jriesen/TennisButler/cv/calibration/calibration-images/IMG_3978.jpeg

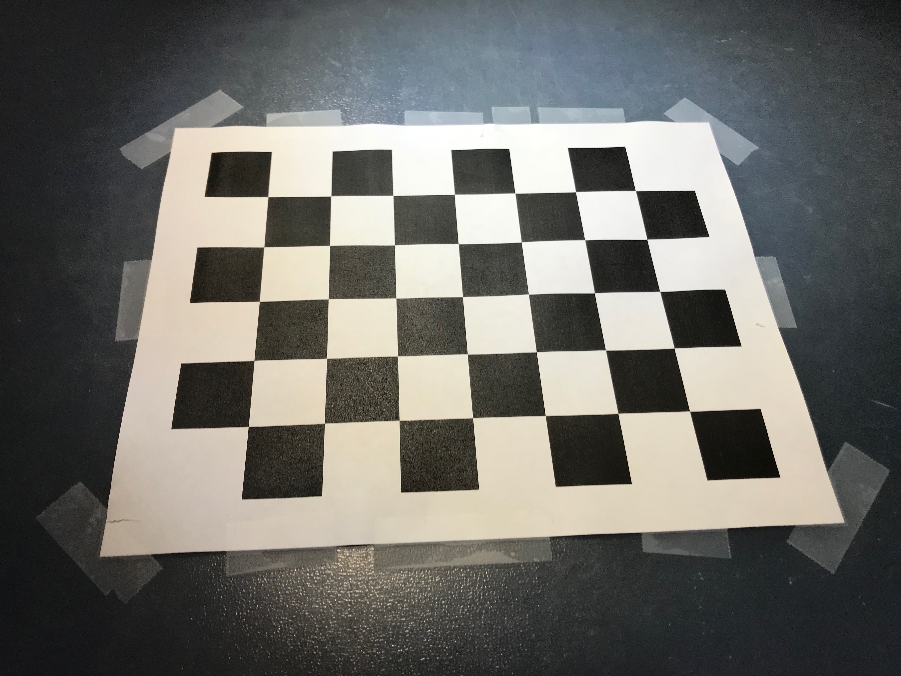
cv/calibration/calibration-images/IMG_3978.jpeg
