jriesen/TennisButler/cv/calibration/calibration-images/IMG_3970.jpeg

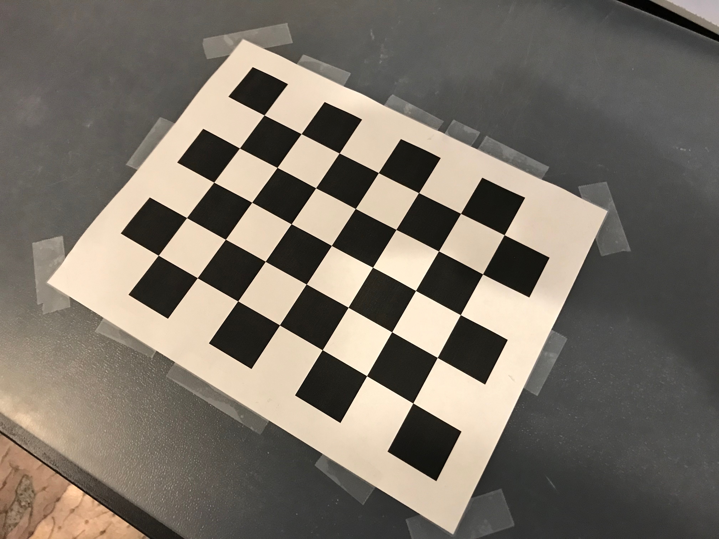
cv/calibration/calibration-images/IMG_3970.jpeg
