jriesen/TennisButler/README.md

# Tennis Butler
All assets for the Tennis Butler autonomous ball collector (senior design project)
