jriesen/TennisButler/cv/court_transform/images/IMG_3774.jpeg

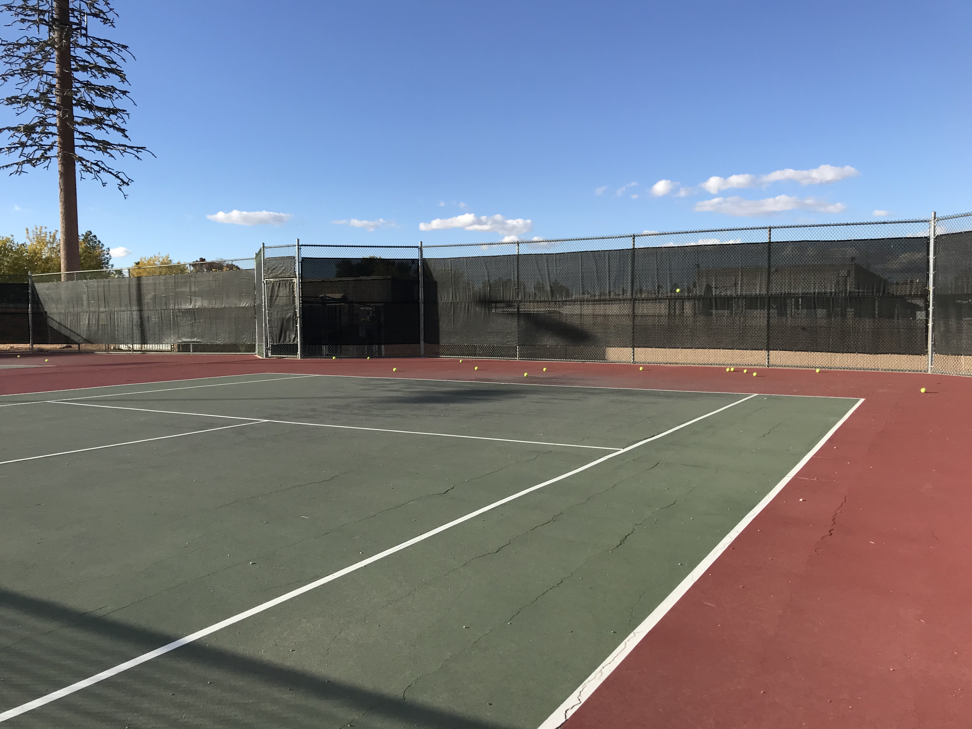
cv/court_transform/images/IMG_3774.jpeg
