jriesen/TennisButler/cv/court_transform/images/IMG_3787.jpeg

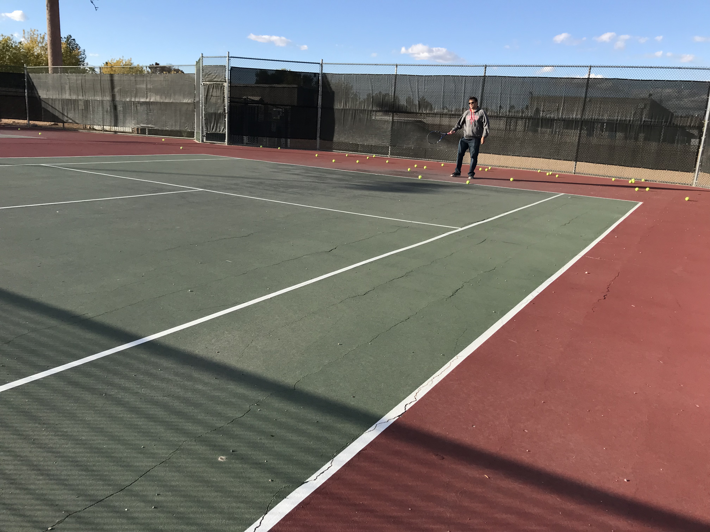
cv/court_transform/images/IMG_3787.jpeg
