jriesen/TennisButler/cv/court_transform/images/IMG_3933.jpeg

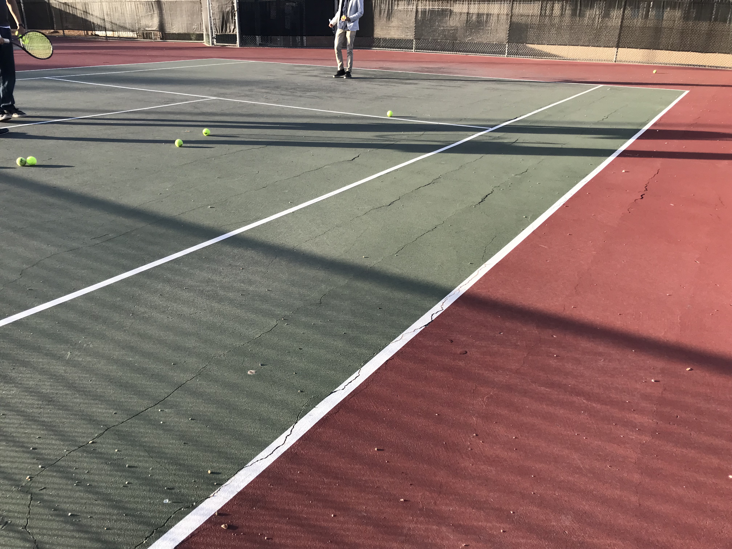
cv/court_transform/images/IMG_3933.jpeg
