jriesen/TennisButler/cv/court_transform/images/IMG_3947.jpeg

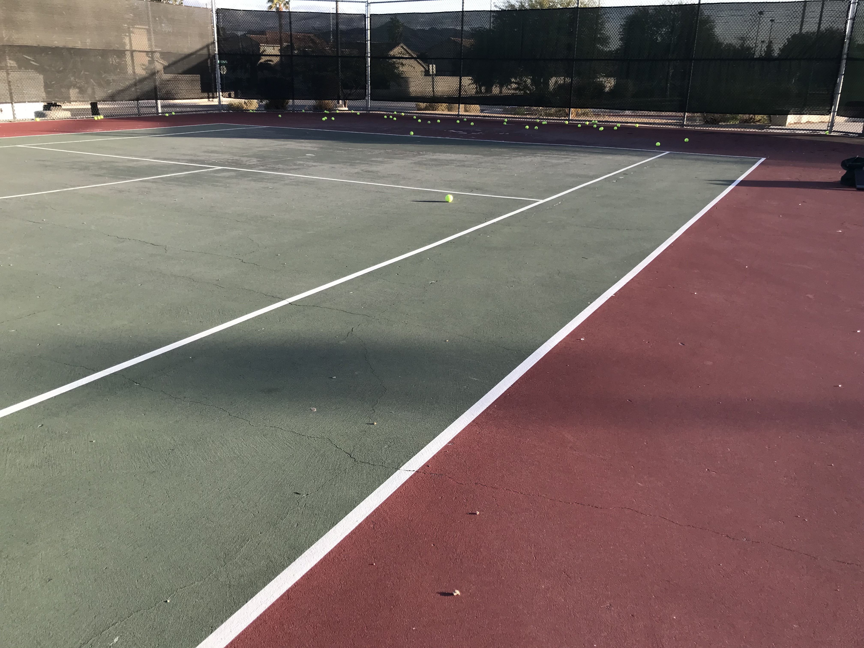
cv/court_transform/images/IMG_3947.jpeg
