jriesen/TennisButler/original-cv/court.jpg

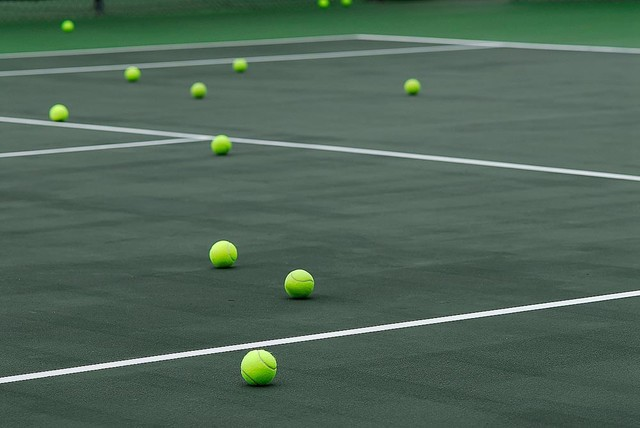
original-cv/court.jpg
