jriesen/TennisButler/cv/calibration/calibration-images/IMG_3965.jpeg

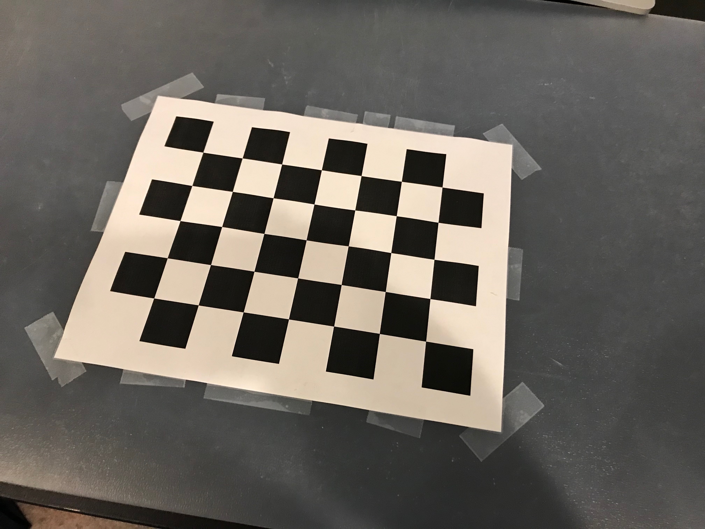
cv/calibration/calibration-images/IMG_3965.jpeg
