jriesen/TennisButler/cv/calibration/calibration-images/IMG_3966.jpeg

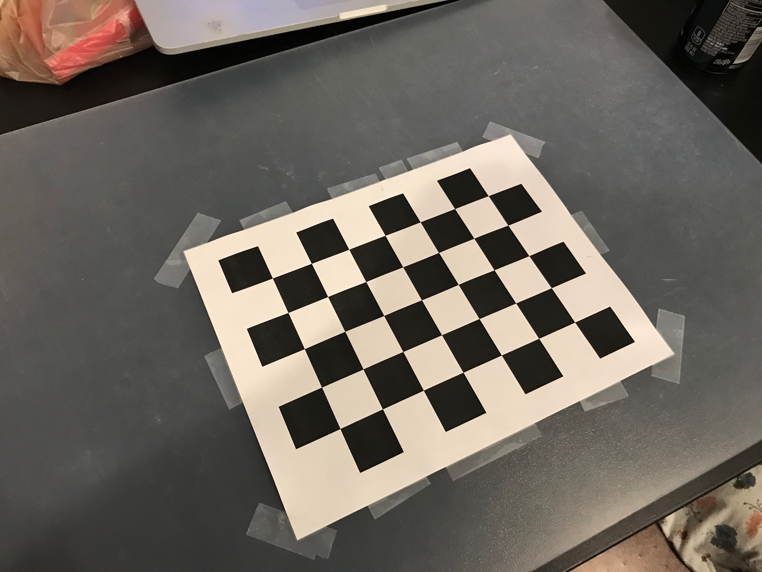
cv/calibration/calibration-images/IMG_3966.jpeg
