jriesen/TennisButler/cv/calibration/calibration-images/IMG_3967.jpeg

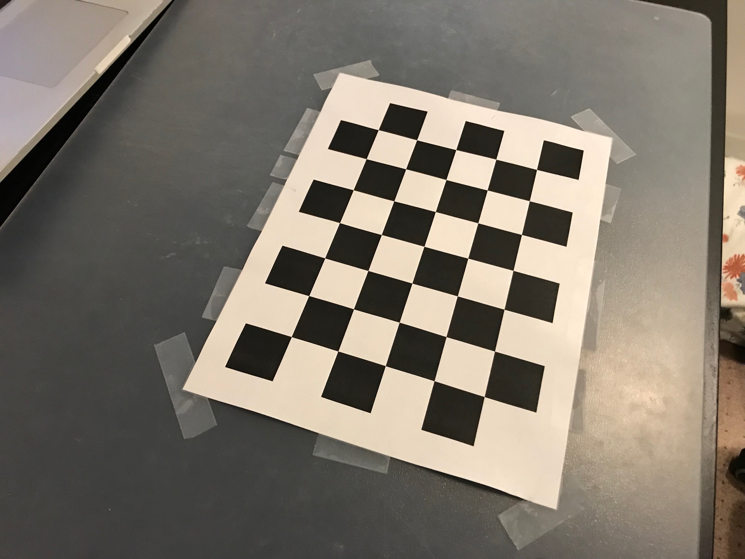
cv/calibration/calibration-images/IMG_3967.jpeg
