jriesen/TennisButler/cv/calibration/calibration-images/IMG_3968.jpeg

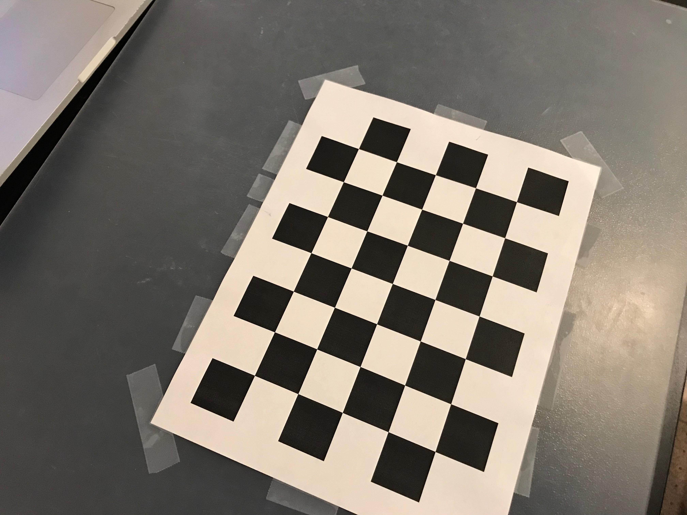
cv/calibration/calibration-images/IMG_3968.jpeg
