jriesen/TennisButler/cv/calibration/calibration-images/IMG_3969.jpeg

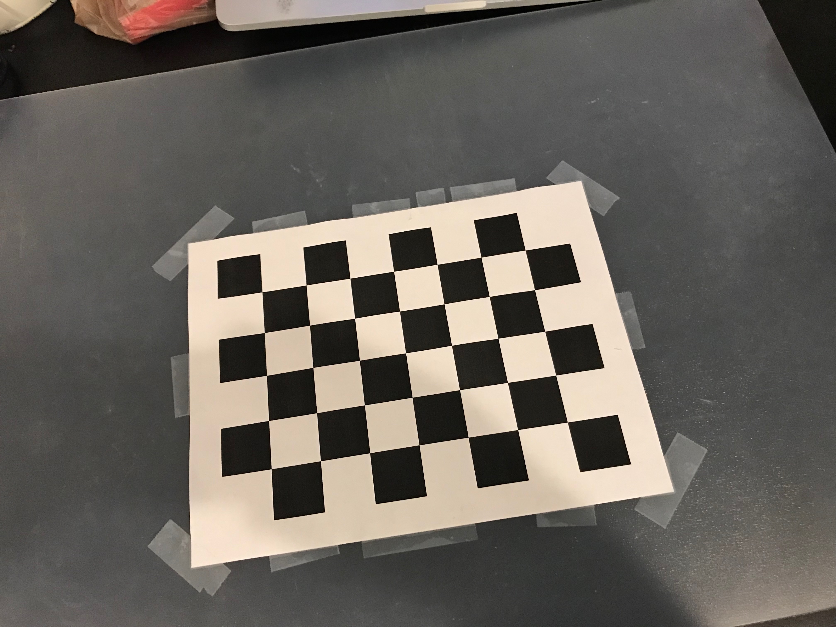
cv/calibration/calibration-images/IMG_3969.jpeg
