jriesen/TennisButler/cv/calibration/calibration-images/IMG_3971.jpeg

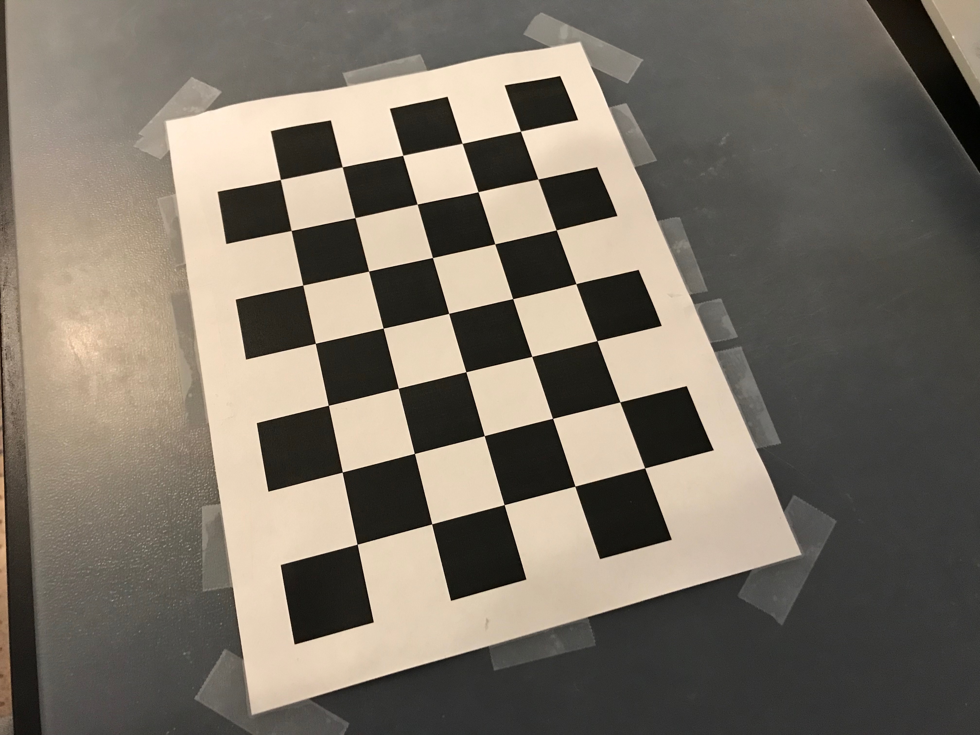
cv/calibration/calibration-images/IMG_3971.jpeg
