jriesen/TennisButler/cv/calibration/calibration-images/IMG_3972.jpeg

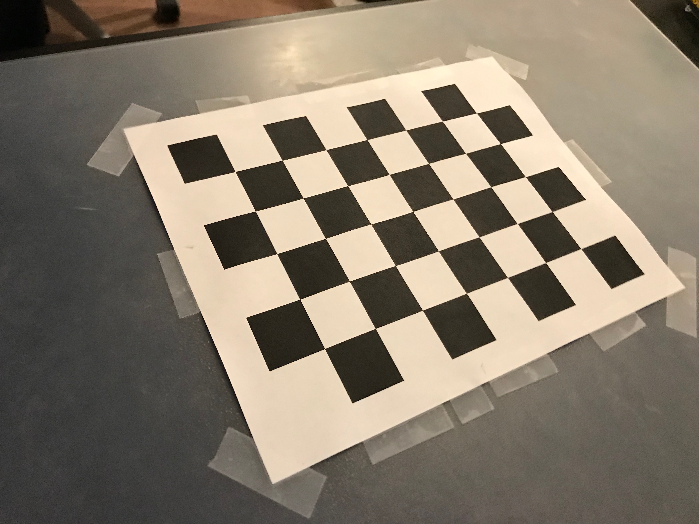
cv/calibration/calibration-images/IMG_3972.jpeg
