jriesen/TennisButler/cv/calibration/calibration-images/IMG_3973.jpeg

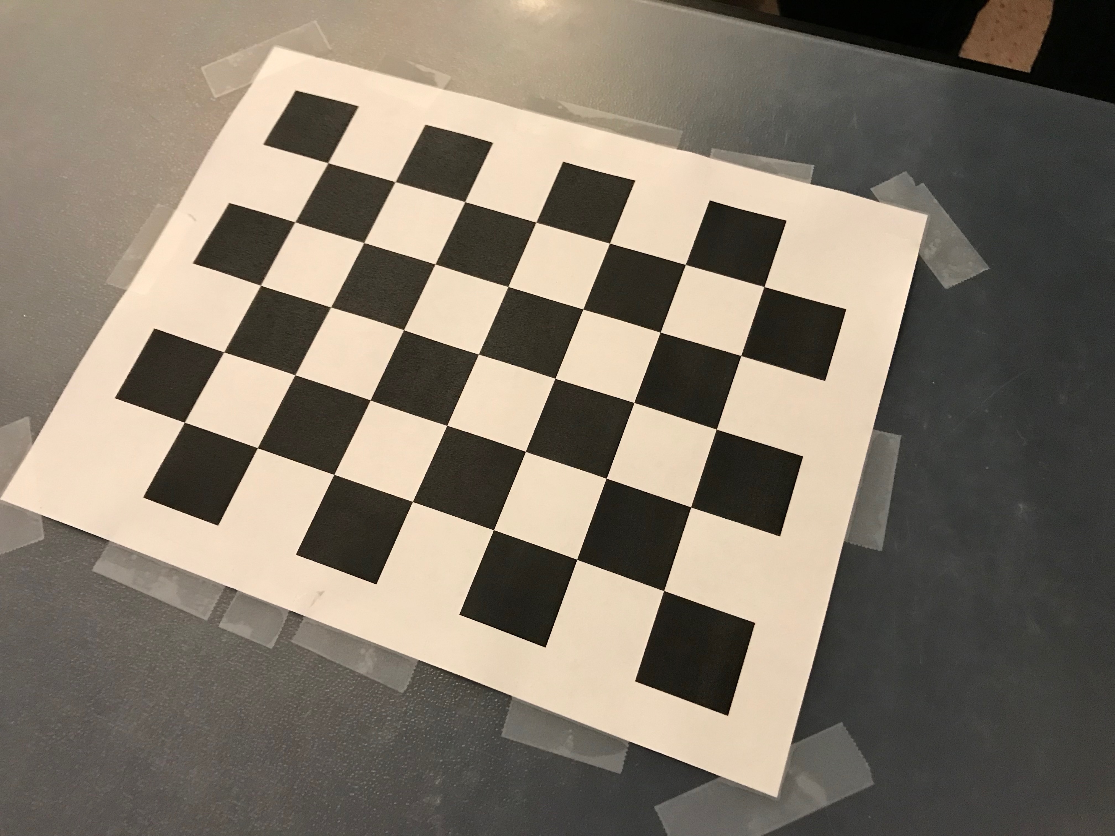
cv/calibration/calibration-images/IMG_3973.jpeg
