jriesen/TennisButler/cv/calibration/calibration-images/IMG_3974.jpeg

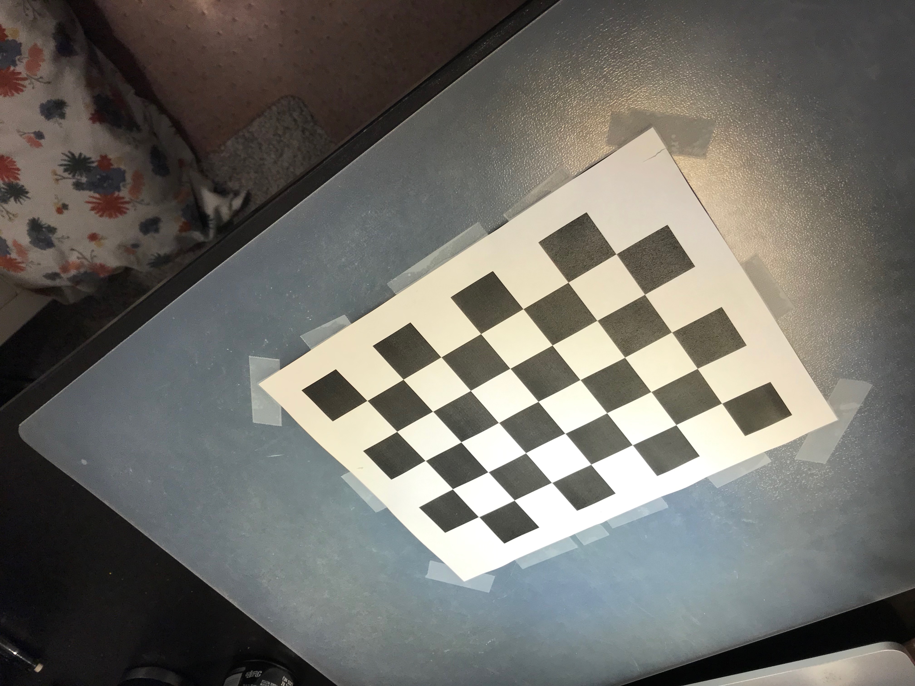
cv/calibration/calibration-images/IMG_3974.jpeg
