jriesen/TennisButler/cv/calibration/calibration-images/IMG_3975.jpeg

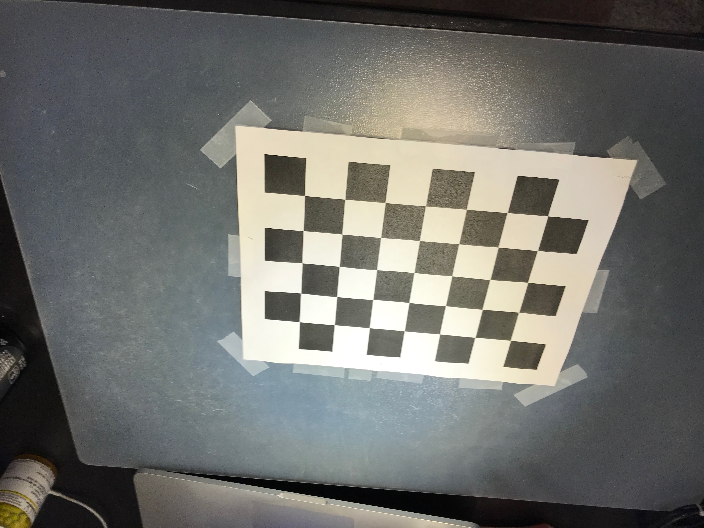
cv/calibration/calibration-images/IMG_3975.jpeg
