jriesen/TennisButler/cv/calibration/calibration-images/IMG_3977.jpeg

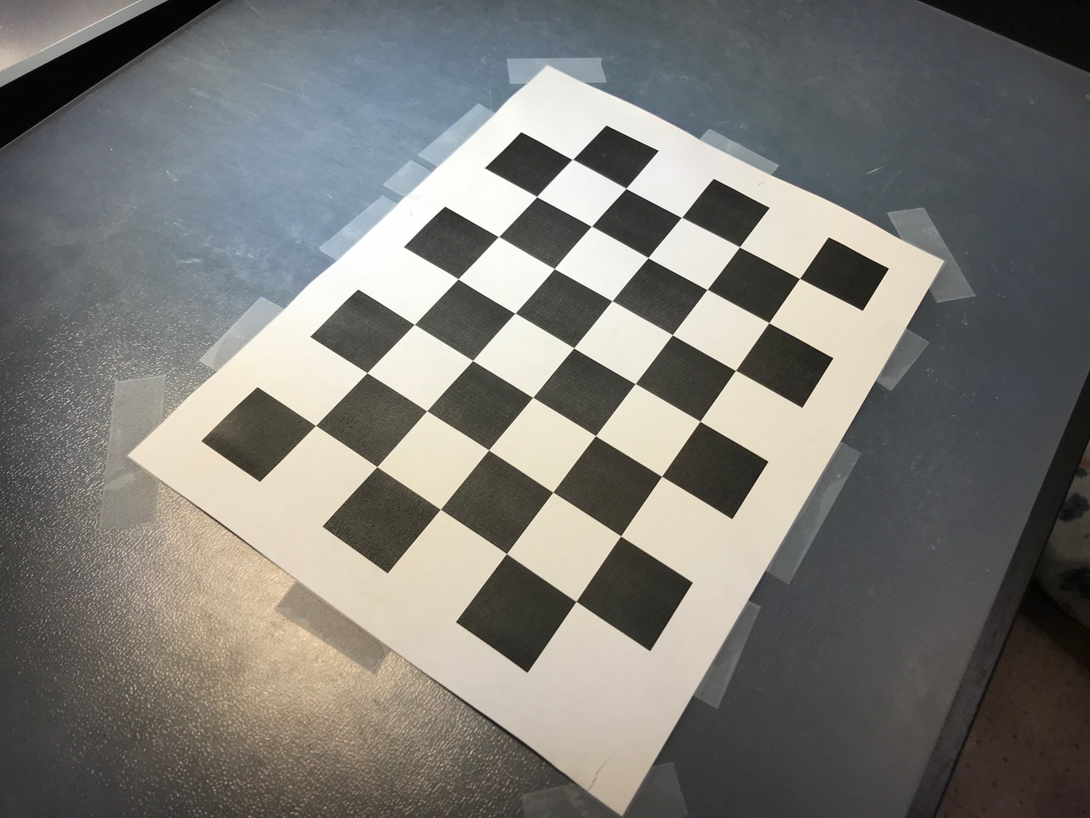
cv/calibration/calibration-images/IMG_3977.jpeg
