jriesen/TennisButler/cv/calibration/calibration-images/IMG_3983.jpeg

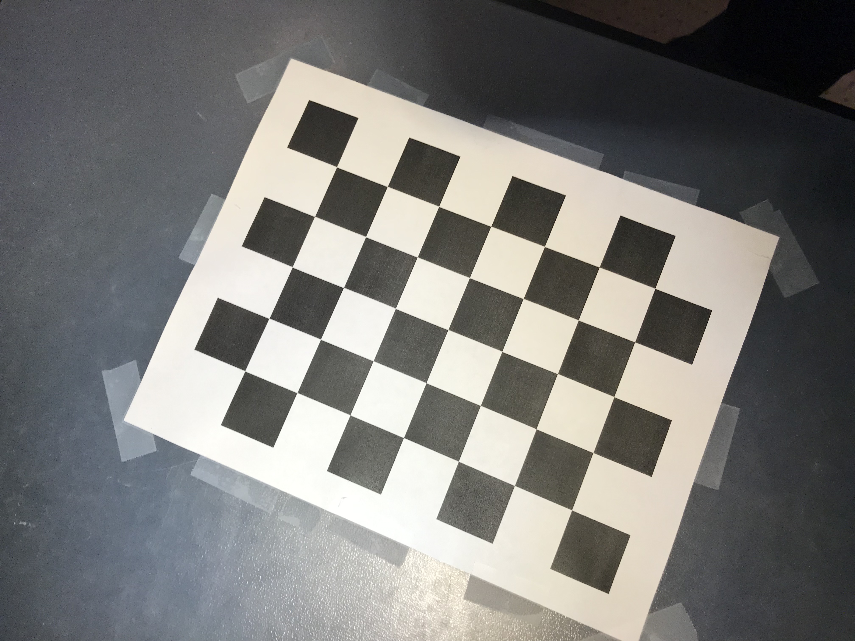
cv/calibration/calibration-images/IMG_3983.jpeg
