jriesen/TennisButler/cv/calibration/calibration-images/IMG_3984.jpeg

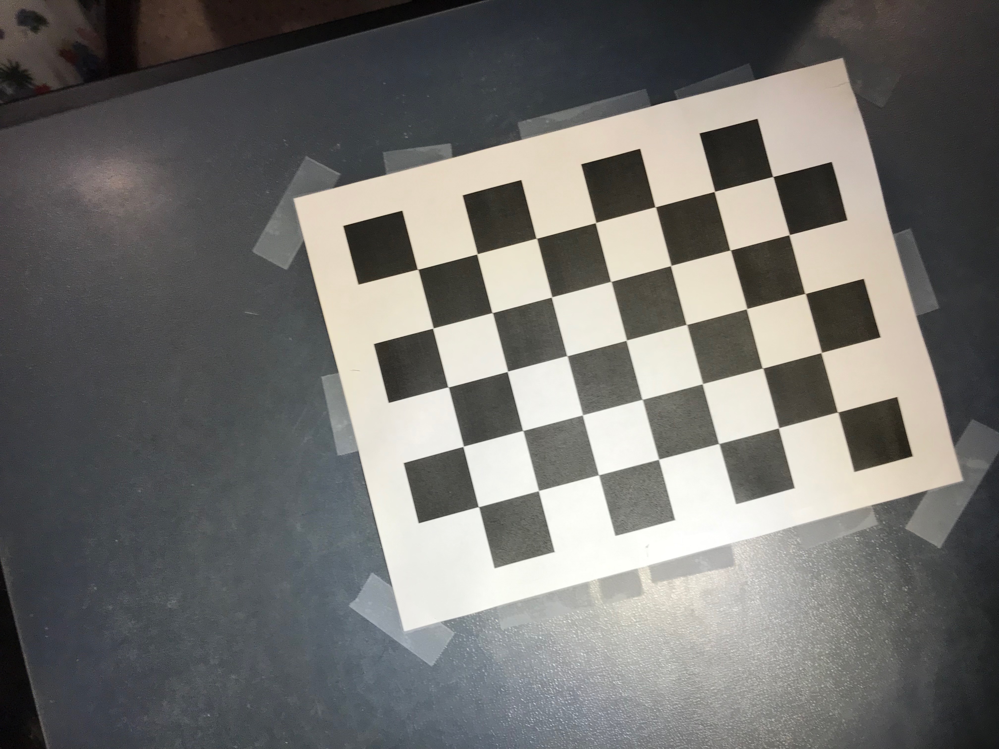
cv/calibration/calibration-images/IMG_3984.jpeg
