jriesen/TennisButler/cv/calibration/calibration-images/IMG_3992.jpeg

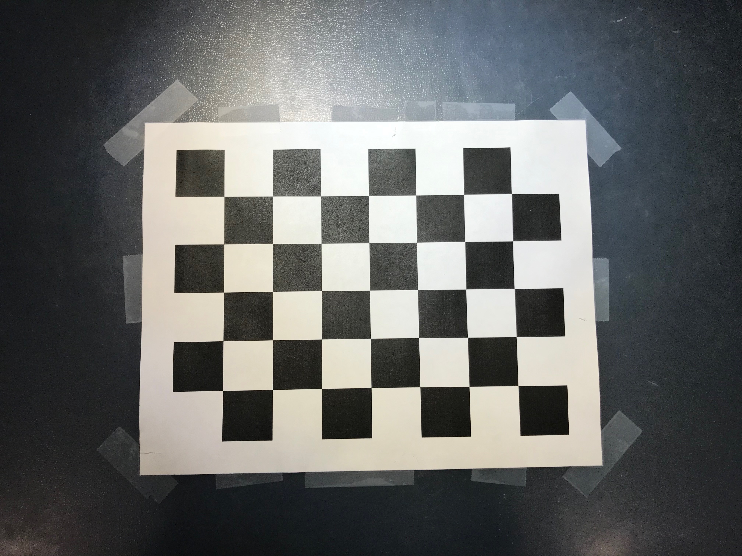
cv/calibration/calibration-images/IMG_3992.jpeg
