jriesen/TennisButler/cv/calibration/calibration-images/IMG_3993.jpeg

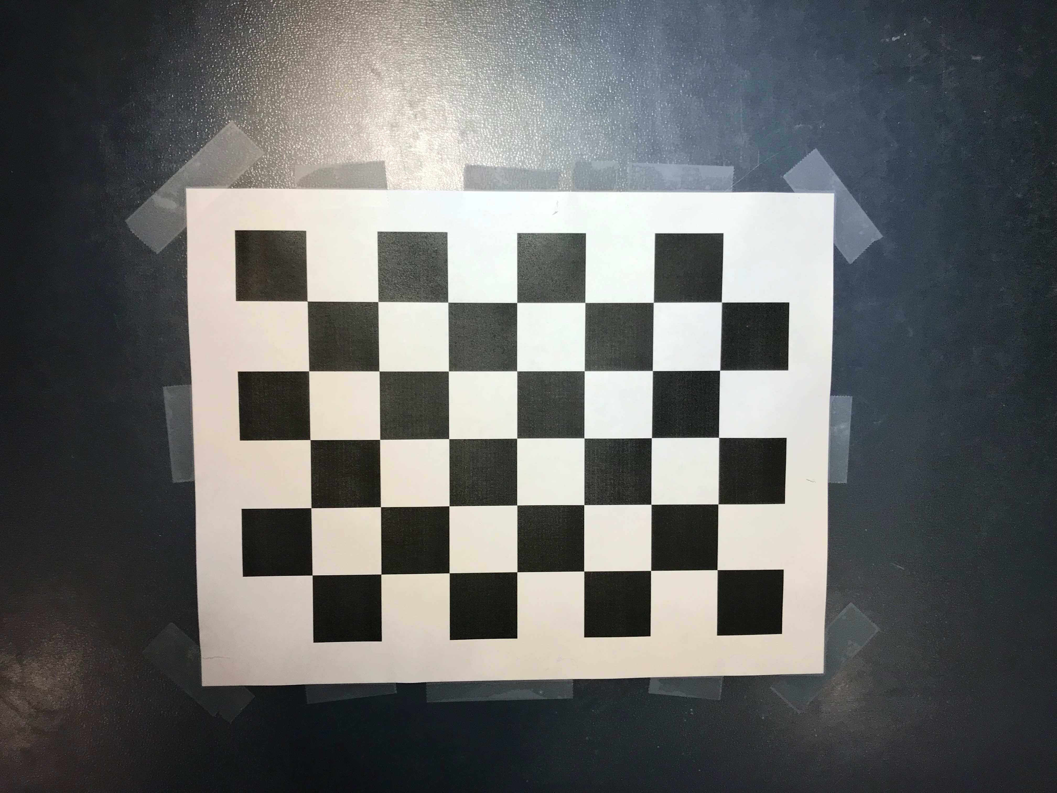
cv/calibration/calibration-images/IMG_3993.jpeg
