jriesen/TennisButler/cv/calibration/calibration-images/IMG_3994.jpeg

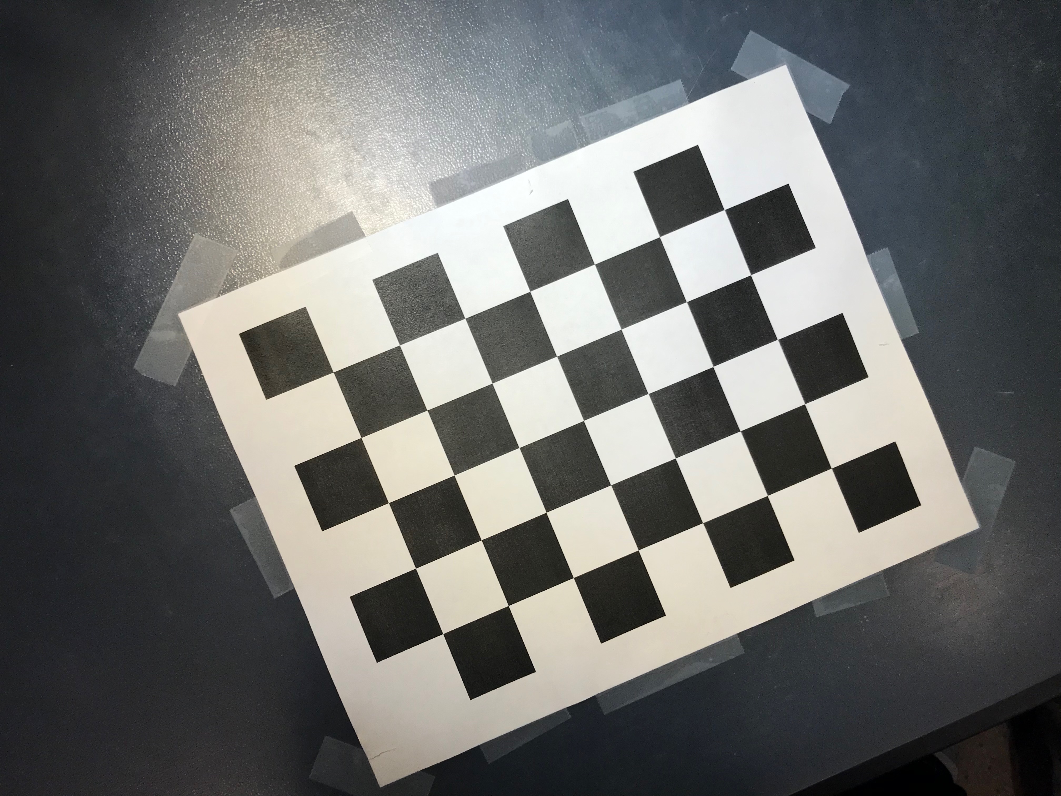
cv/calibration/calibration-images/IMG_3994.jpeg
