jriesen/TennisButler/hardware/Documentation/Schematics.PDF

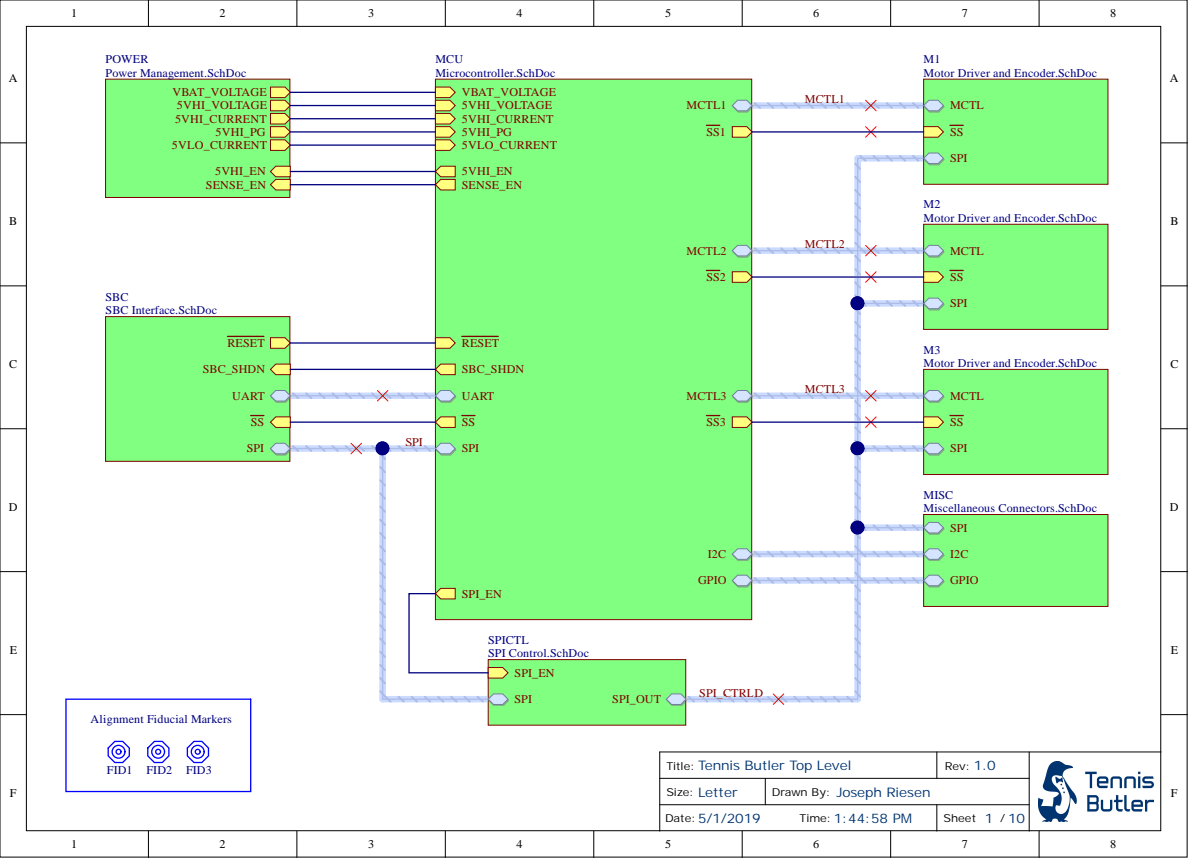
[picture p24: page 1]

Motor Driver and Encoder.SchDoc

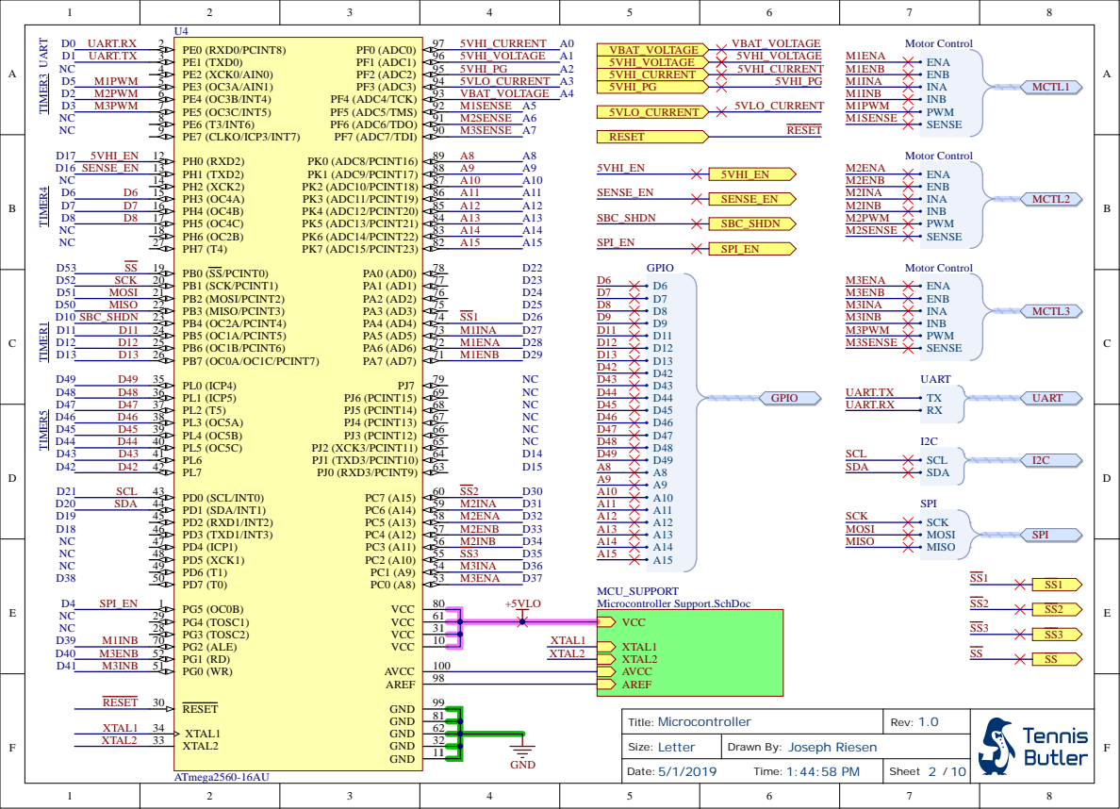
[picture p25: page 2]

8 1
6 2

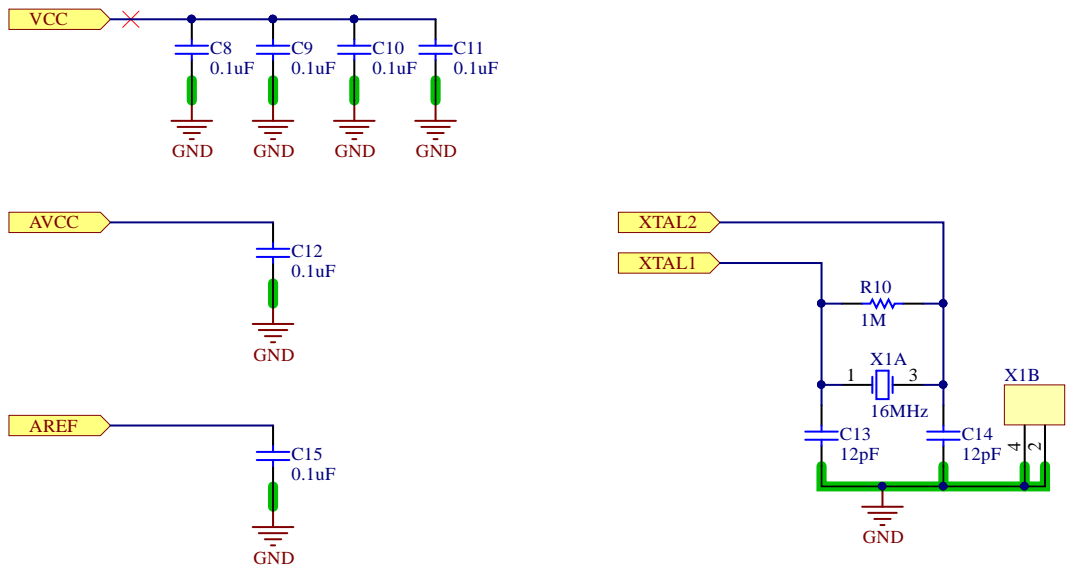
[picture p26: page 3]

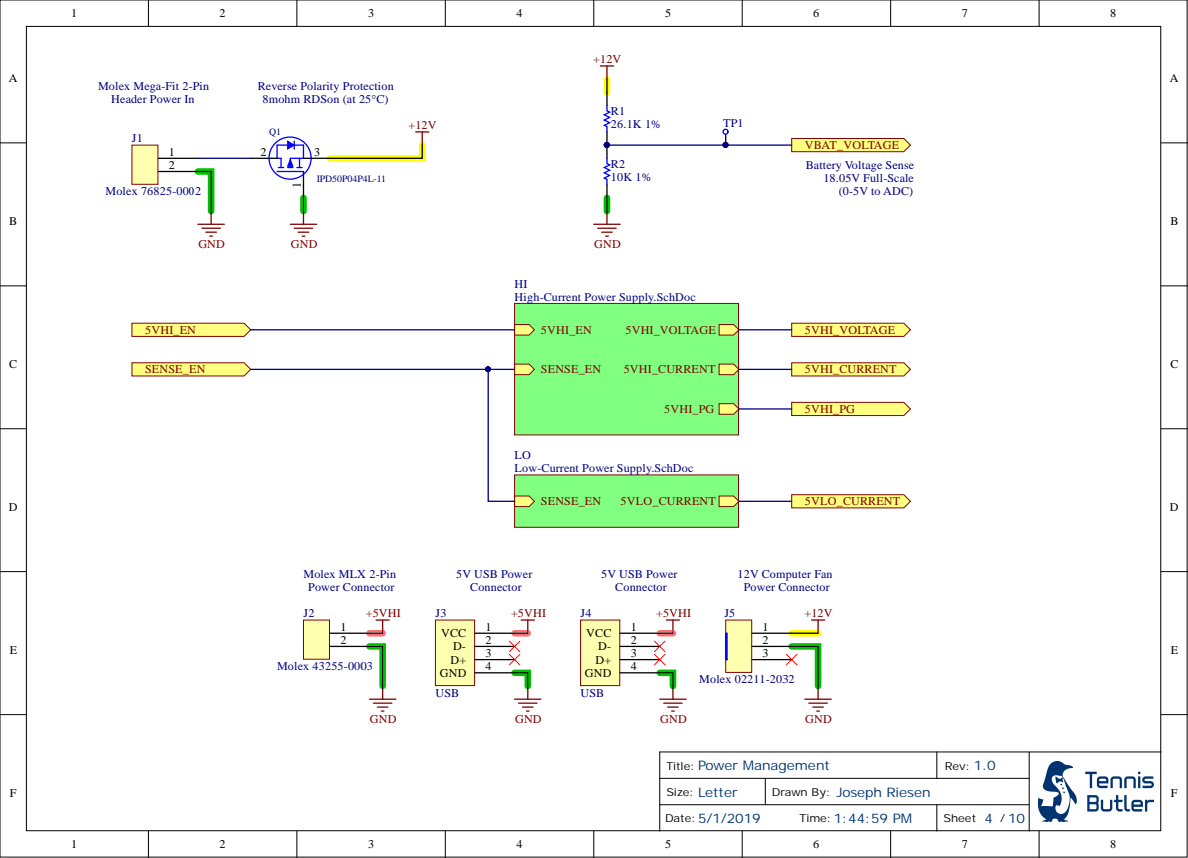
[picture p27: page 4]

Molex Mega-Fit 2-Pin
Header Power In

High-Current Power Supply.SchDoc

Low-Current Power Supply.SchDoc

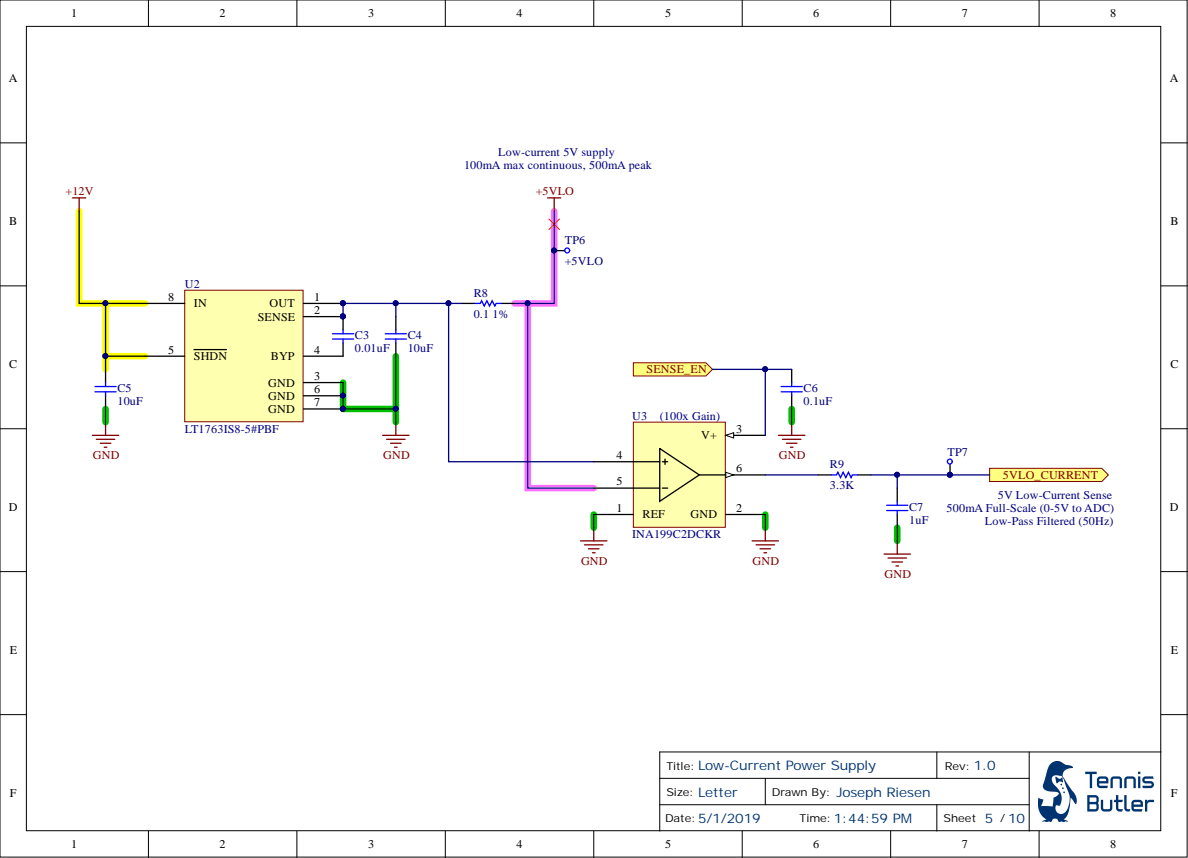
[picture p28: page 5]

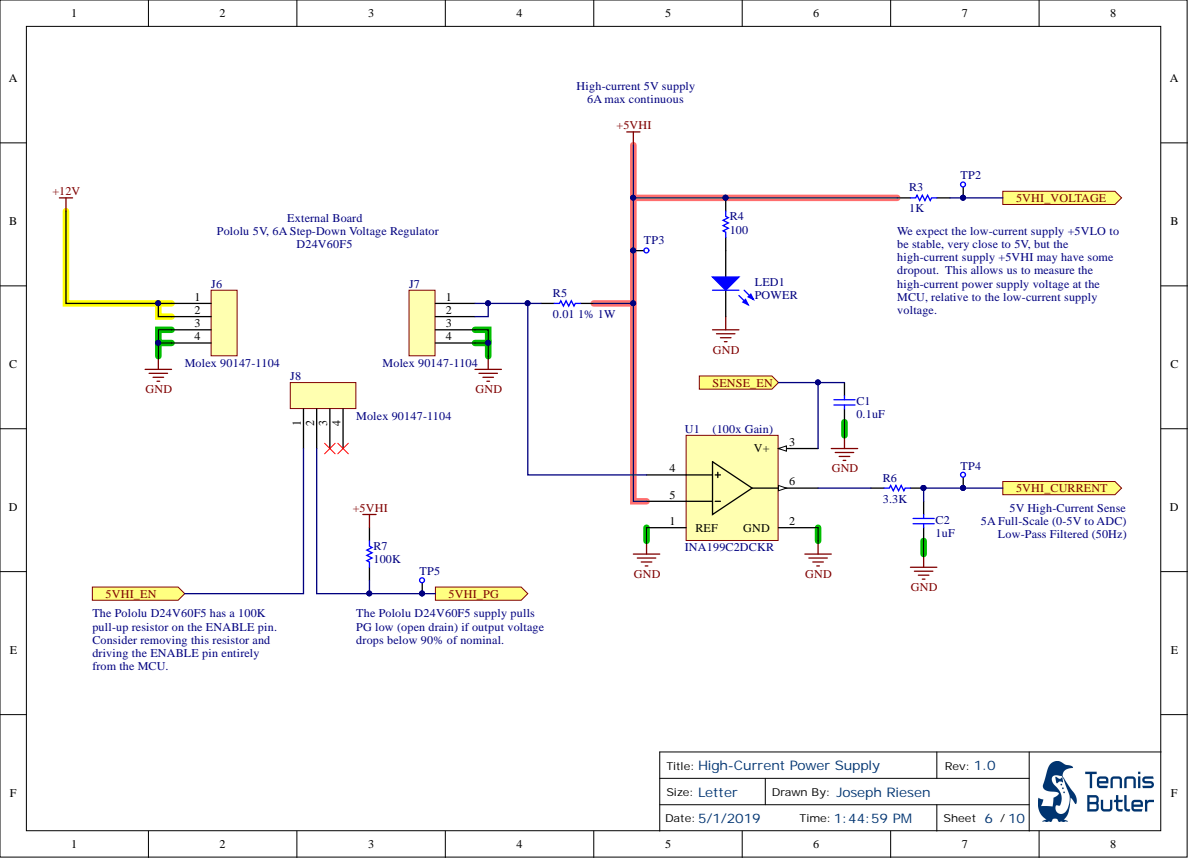
[picture p29: page 6]

Pololu 5V, 6A Step-Down Voltage Regulator

We expect the low-current supply +5VLO to
be stable, very close to 5V, but the
high-current supply +5VHI may have some
dropout. This allows us to measure the
high-current power supply voltage at the
MCU, relative to the low-current supply
voltage.

5VHI_CURRENT
5V High-Current Sense
5A Full-Scale (0-5V to ADC)
Low-Pass Filtered (50Hz)

The Pololu D24V60F5 has a 100K
pull-up resistor on the ENABLE pin.
Consider removing this resistor and
driving the ENABLE pin entirely
from the MCU.

The Pololu D24V60F5 supply pulls
PG low (open drain) if output voltage
drops below 90% of nominal.

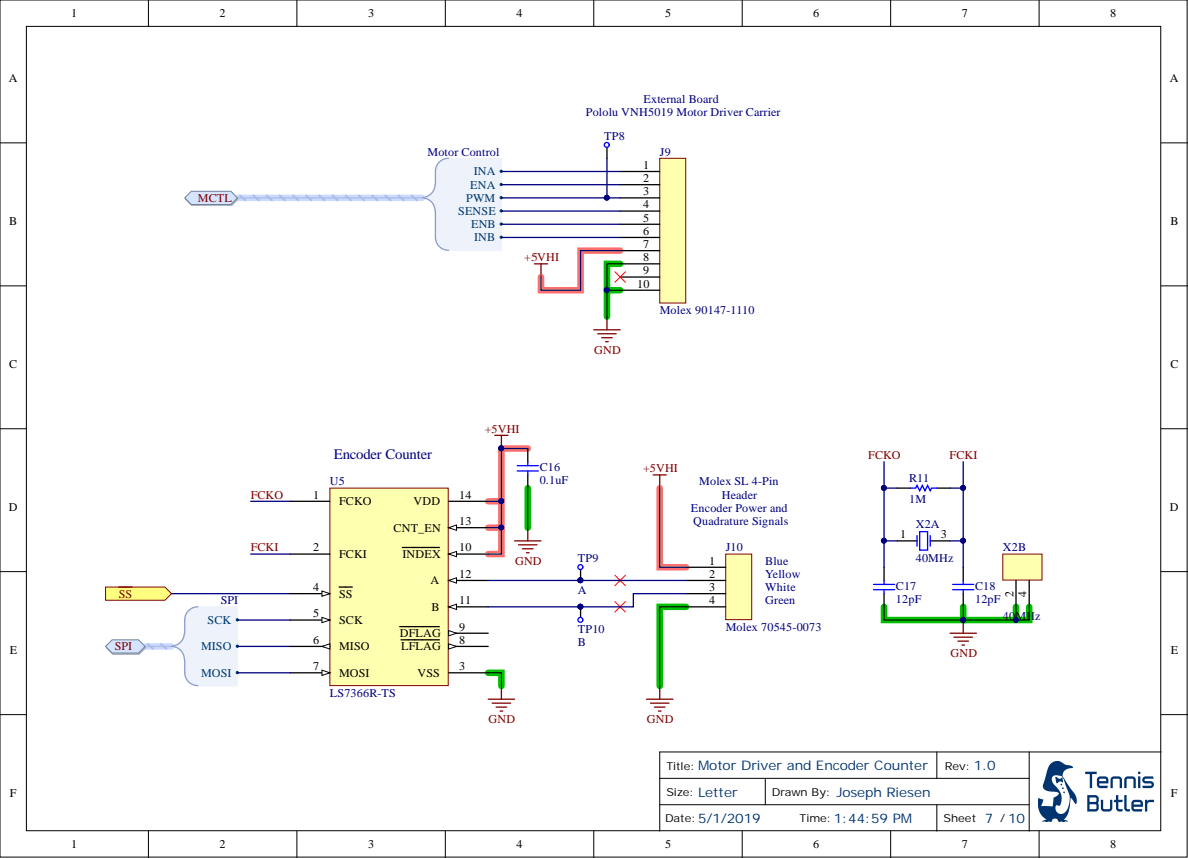
[picture p30: page 7]

Pololu VNH5019 Motor Driver Carrier

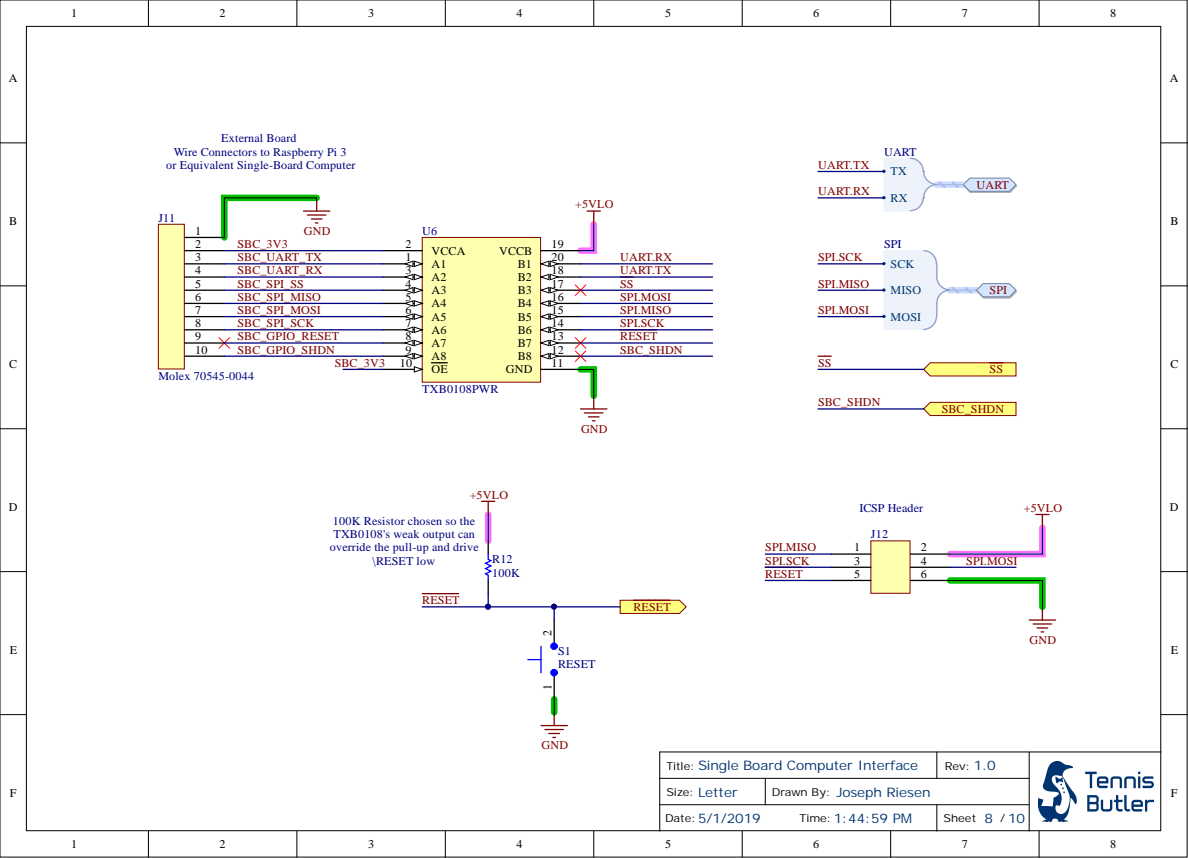
[picture p31: page 8]

Wire Connectors to Raspberry Pi 3
or Equivalent Single-Board Computer

100K Resistor chosen so the
TXB0108's weak output can
override the pull-up and drive

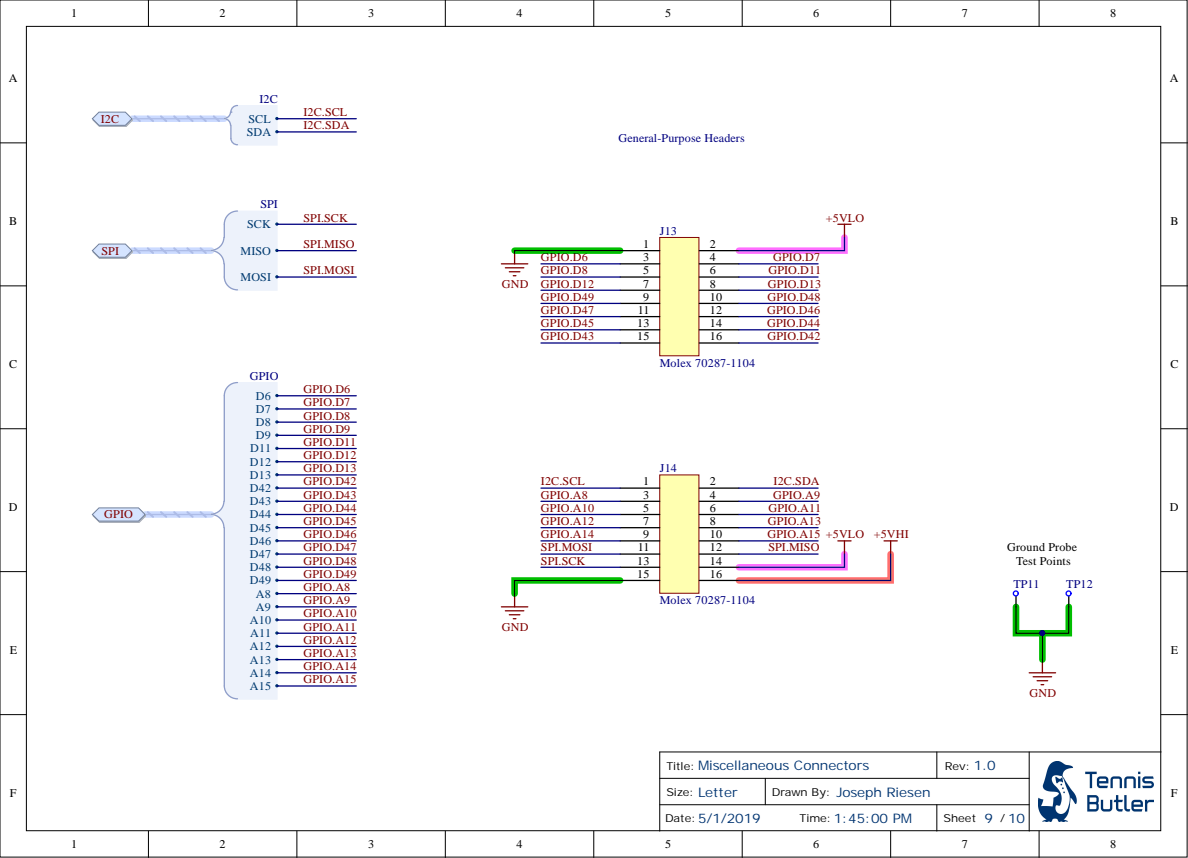
[picture p32: page 9]

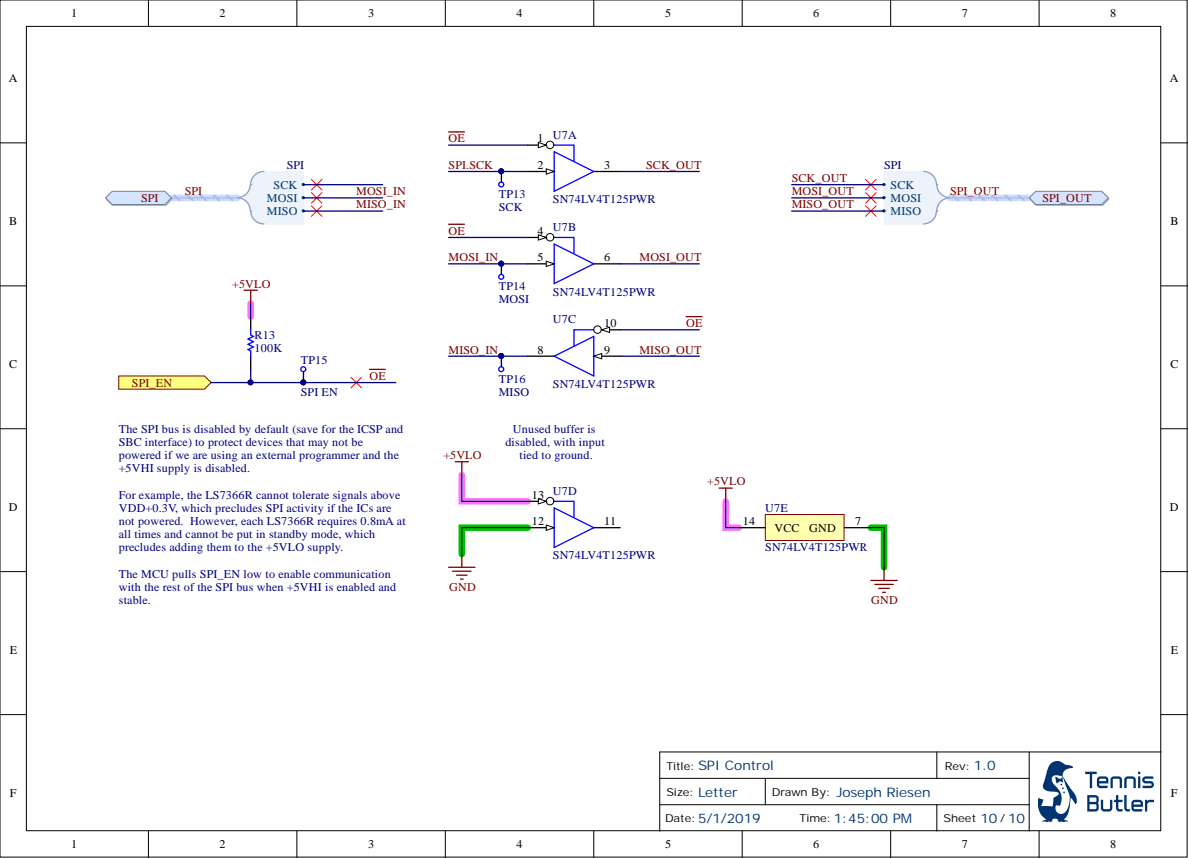
[picture p33: page 10]

The SPI bus is disabled by default (save for the ICSP and
SBC interface) to protect devices that may not be
powered if we are using an external programmer and the
+5VHI supply is disabled.

For example, the LS7366R cannot tolerate signals above
VDD+0.3V, which precludes SPI activity if the ICs are
not powered. However, each LS7366R requires 0.8mA at
all times and cannot be put in standby mode, which
precludes adding them to the +5VLO supply.

The MCU pulls SPI_EN low to enable communication
with the rest of the SPI bus when +5VHI is enabled and
stable.
