jriesen/TennisButler/hardware/Documentation/PCB.PDF

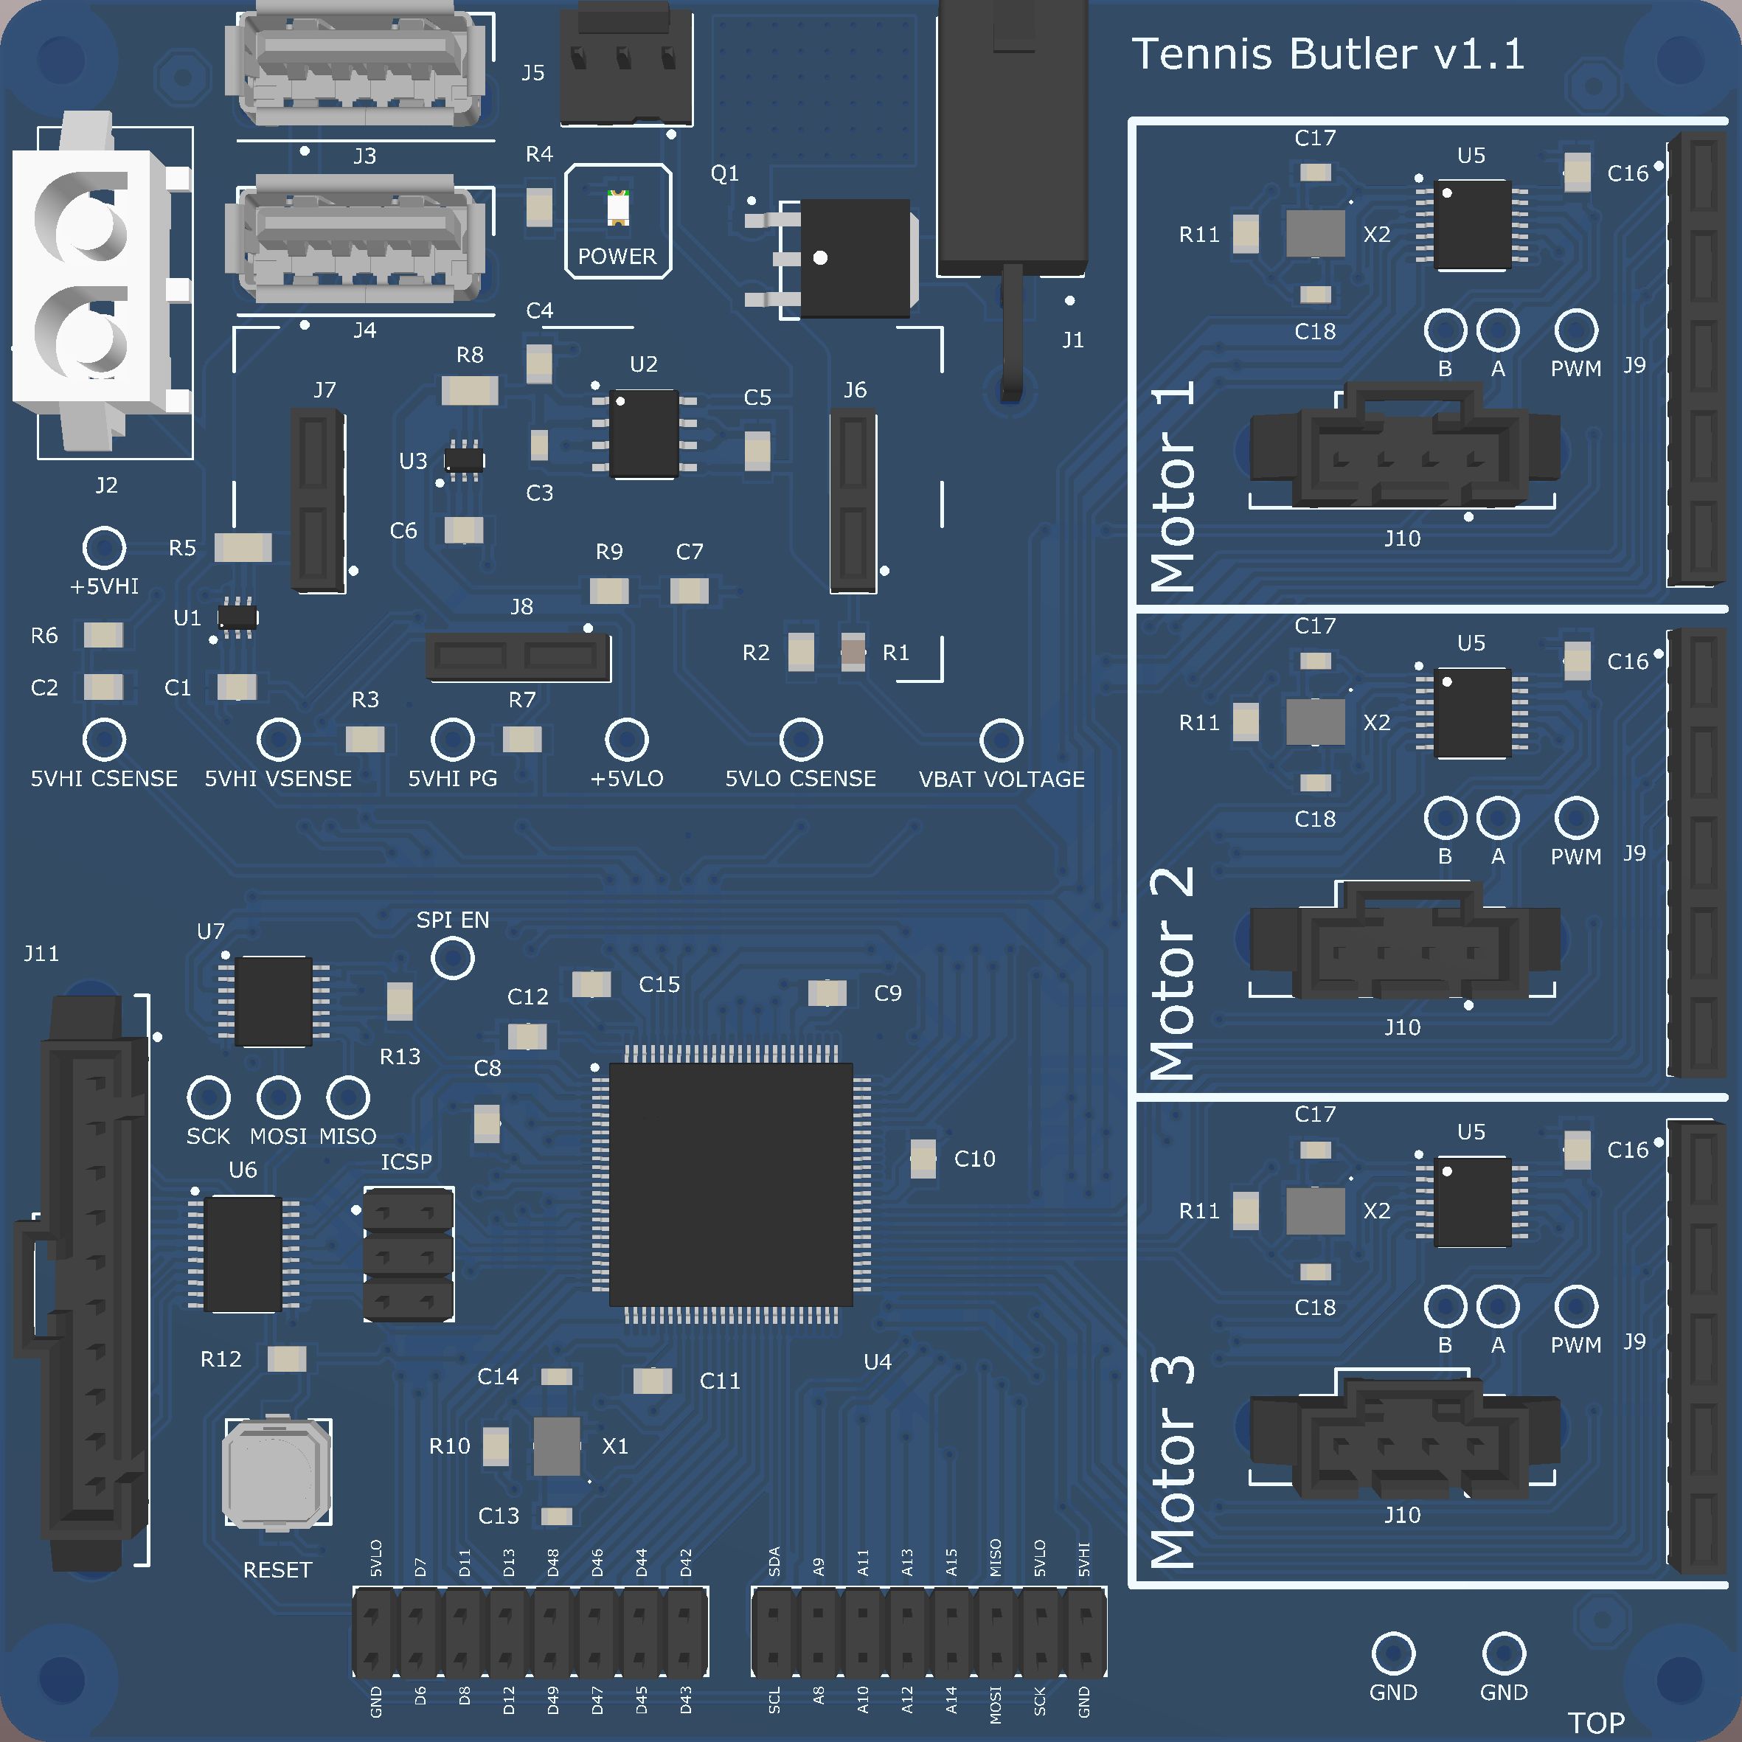
[picture p34: page 1]

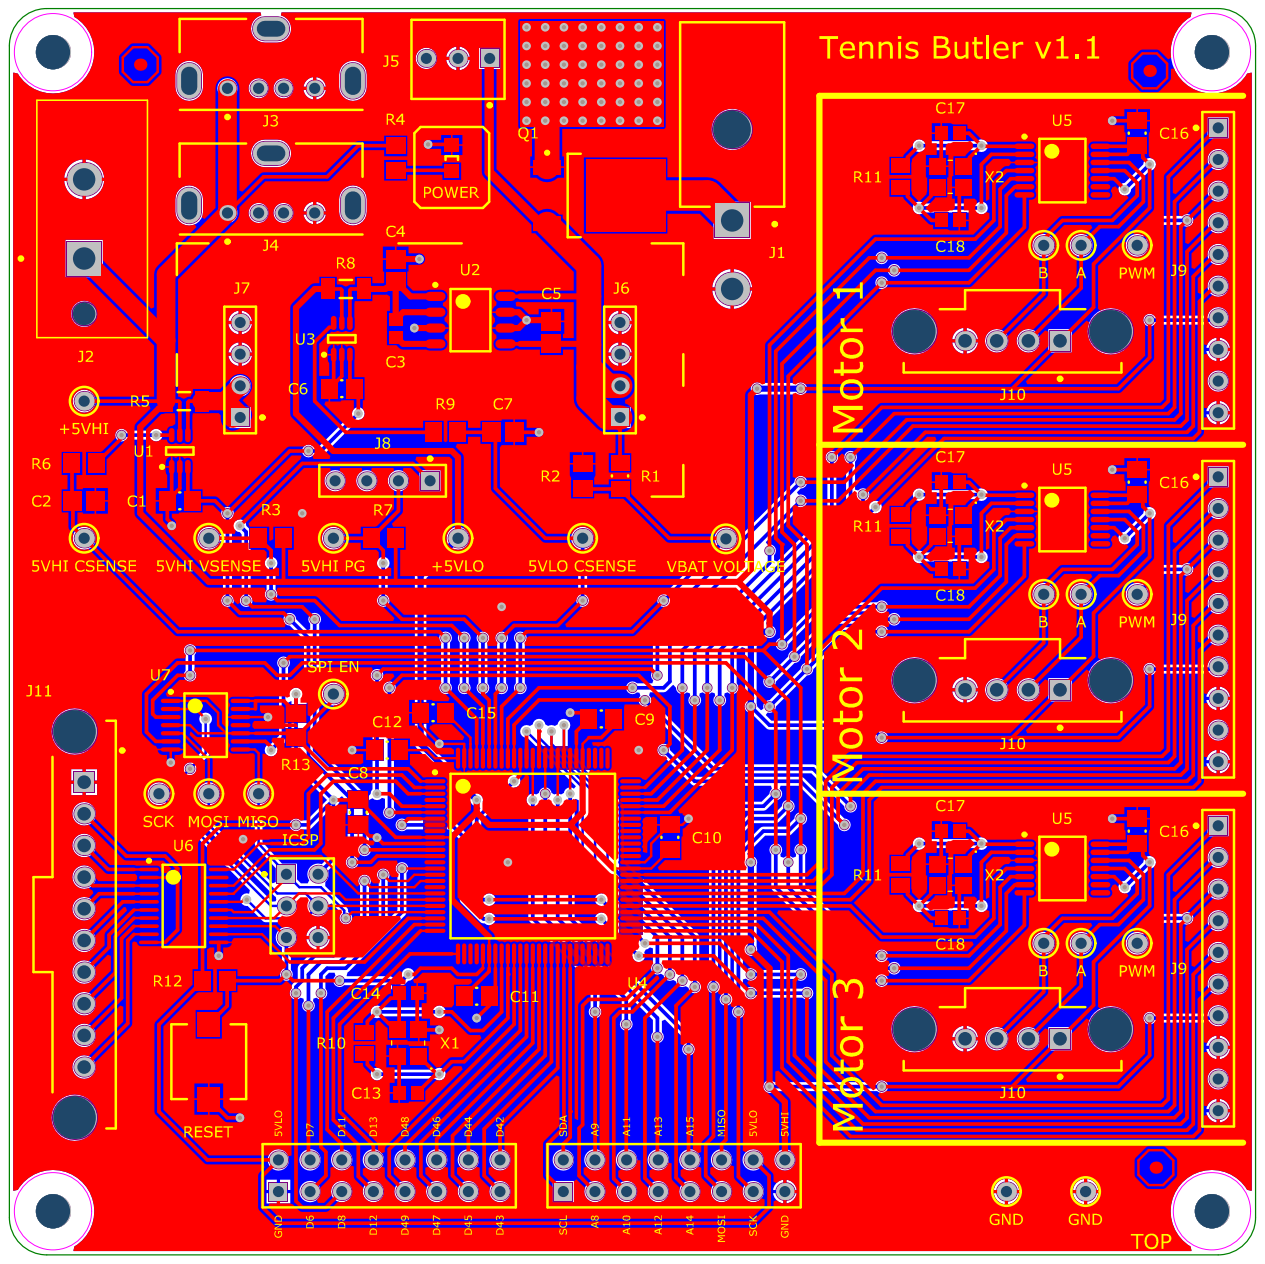
[picture p35: page 2]
