jriesen/TennisButler/(list of files, drawings)

Other design files:
hardware/PCB/TennisButler PCB.PcbDoc
hardware/Schematics/High-Current Power Supply.SchDoc
hardware/Schematics/LED Driver.SchDoc
hardware/Schematics/Low-Current Power Supply.SchDoc
hardware/Schematics/Microcontroller Support.SchDoc
hardware/Schematics/Microcontroller.SchDoc
hardware/Schematics/Miscellaneous Connectors.SchDoc
hardware/Schematics/Motor Driver and Encoder.SchDoc
hardware/Schematics/Power Management.SchDoc
hardware/Schematics/SBC Interface.SchDoc
hardware/Schematics/SPI Control.SchDoc
hardware/Schematics/Tennis Butler V1.0.SchDoc
hardware/TennisButler.PrjPcb
