jriesen/TennisButler/(commit log)

2018-12-06 Add new CV code: calibration, tennis court mapping
    The calibration photos probably aren't the best; I need to redo them
    with a rigid chessboard or the like. Then again, the iPhone photos
    are only for algorithm design and we'll be moving to a Pi camera V2
    very soon.
2019-03-06 Add initial Altium files to project
    This initial commit adds my current work on the Tennis Butler in
    Altium to the project. Mostly it's library footprint work and some
    initial work on a schematic template for the title block.
    [01 TOC.SchDoc, TennisButler PCB.PcbDoc, TennisButler.PrjPcb]
2019-03-09 Add a proper schematic template with logo
    [01 TOC.SchDoc]
2019-03-09 Update schematic template to 1-inch margins
    [01 TOC.SchDoc, TennisButler.PrjPcb]
2019-03-09 Alter TSOP-14 footprints to have rectangular pad 1
    The EEVBlog guy recommends using a rectangular pad for pin 1 as an extra
    identifier (in addition to the silkscreen) to ensure proper assembly.
2019-03-09 Remove IPC Medium and High Density footprints
    The low density footprint is recommended for "robust" solder joints and
    is recommended for military and medical applications. I don't need a
    very dense board, so I'm just removing these to reduce confusion and
    maintenance overhead. (After all, I still need to patch up the solder
    mask slivers on the pins.)
    See https://blogs.mentor.com/tom-hausherr/blog/2011/01/28/pcb-design-perfection-starts-in-the-cad-library-part-12/
    for more details.
2019-03-09 Add first-pass VNH5019 symbol and footprint
2019-03-09 Add Seeed DRC rule export
    This is my current best effort at interpreting the various Seeed Fusion
    PCB rules (especially for the cheap boards, i.e. 0.4mm solder mask dam)
    into Altium.
2019-03-09 Add "Motor Drivers" schematic sheet
    Not that there's anything in it yet, of course, but at least the title
    block looks great!
    [Motor Drivers.SchDoc, TennisButler.PrjPcb]
2019-03-12 Add Seeed cheap DRC rules to PcbDoc
    I thought I already added these (after all, I exported a rule file) but
    must have reverted the PcbDoc when I was screwing around. The current
    version of Altium 19 crashes when trying to import the rule file (no
    matter what I do!) so I just added the rules again by hand.
    [TennisButler PCB.PcbDoc]
2019-03-12 Finalize VNH5019-E MultiPowerSO footprint with DRC
    This update should complete the VNH5019-E footprint and includes DRC
    exceptions in the PCB for vias placed within pads. I updated the size
    of the vias to match Seeed rules - 12mil hole, 24mil via (6mil to either
    side of the ring), and eliminated solder mask around the vias (since
    they're embedded within the pad's solder mask anyway but were throwing
    DRC errors). I finally added an exception rule for clearance (custom
    rule for vias within that particular footprint) to allow both vias and
    holes to exist within the pads without error.
    [TennisButler PCB.PcbDoc, TennisButler.PrjPcb]
2019-03-12 Regenerate rule that I likely can't import anyway
    I dumped the latest .RUL file for the Seeed implementation, but I
    doubt I can re-import it on the current version of AD19 without it
    crashing anyway.
2019-03-12 Add simple PIO project that tests LS7366R over SPI
    A quick program to validate SPI communication with a LS7366R.
2019-03-14 Rename driver sheet to "Motor Driver and Encoder"
    In moving to a hierarchical schematic layout, it seems appropriate to
    place the motor driver and encoder together in a single child sheet.
    [Motor Driver and Encoder.SchDoc]
2019-03-14 Update project file to include renamed schematic
    Oops, I need to remember to commit the project file too when renaming
    and reorganizing schematics.
    [TennisButler.PrjPcb]
2019-03-14 Add ATmega2560 and adjust footprints
    This adds the ATmega2560 in 100-pin TQFP low-density with an expanded
    solder mask to meet Seeed 0.4mm (cheap) solder mask sliver requirements.
    [01 TOC.SchDoc, Microcontroller.SchDoc, Motor Driver and Encoder.SchDoc, TennisButler PCB.PcbDoc, TennisButler.PrjPcb]
2019-03-20 Change rectangular pin 1 back to rounded
    Given the silkscreen, there's no reason to _also_ make pin 1
    rectangular, that's just an old-school suggestion from the EEVBlog guy.
2019-03-20 Tweak footprint solder mask and silkscreen for DRC
2019-03-21 Fix up footprints and add more schematics to test
    As it turns out, if you download a PcbLib/SchLib from the Manufacturer
    Part Search system, those files remain linked to Altium Content Vault
    online. This isn't inherently a bad thing... but the problem is that
    you're stuck with those footprints. You can add new footprints into the
    file from an IntLib, but once you try to implement them in a PCB you get
    errors trying to push from the schematic, and if you just add the part
    in the PCB and try to link it back, you get "Component not found in
    available libraries" since your footprint isn't on Altium's cloud
    server. And I need to customize the footprints to meet Seeed's cheap
    solder mask sliver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
    [01 TOC.SchDoc, Microcontroller.SchDoc, Motor Driver and Encoder.SchDoc, Power Management.SchDoc, TennisButler PCB.PcbDoc, TennisButler.PrjPcb]
2019-03-21 Add simple PCB connector for scale
    Just trying to get a feel for the dimensions of the PCB and how much
    hardware we can fit.
    [TennisButler PCB.PcbDoc]
2019-03-22 Add Molex Mega-Fit and fix all mechanical layers
    So apparently Altium 19 adds a nifty feature where you can group
    mechanical layers into pairs and assign them a name, instead of
    painstakingly remapping every part you import. However, it seems like
    their new standard expects assembly on mech-2/3, courtyard on mech-4/5,
    and 3D Body on mech-6/7, where previously the 3D Body and Assembly were
    in 13/14 and the courtyard in 15/16. This makes for a minor hassle when
    importing their own parts from the Content Vault, but once everything is
    sorted out, it looks much prettier.
    I also added a two-pin Molex Mega Fit connector (76825-0002) with a
    footprint from SnapEDA, my own schematic, and I also suc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
    [TennisButler PCB.PcbDoc, TennisButler.PrjPcb]
2019-03-23 Adjusted unmated connector height
    Curiously, this value (under Edit for the footprint within the PCB
    Library panel) doesn't actually get compiled into the LibPkg, so maybe
    nobody actually uses it. Anyway, I corrected the Molex connector's
    height to 14.53mm, its actual unmated height. I'm guessing that for
    keepout the actual part Parameter "height" is what matters? Not sure.
2019-03-23 Update library components to add description
    Added descriptions for the LS7366R and VNH5019ATR-E.
    Also includes correct pin count information (apparently it needs the Pin
    Count parameter set, not the Number of Pins parameter from Altium
    Content Library, hah). Added supplier and pricing info to the LS7366R
    (not that it helps in the BOM really, or the SCH Library supplier links
    list).
2019-03-23 Committing accidental change made while staged
2019-03-23 Renaming schematic libraries to match exactly
    This way the files actually match their exact component.
2019-03-26 General check-in
    Been messing around a lot, want to commit the current working version.
    I've renamed the TOC but I think I want to rename it again; sadly the
    Storage Manager sees a pending change and won't let me rename it within
    the project, so I need to commit this before renaming it again.
    [Microcontroller.SchDoc, Motor Driver and Encoder.SchDoc, TennisButler PCB.PcbDoc, TennisButler.PrjPcb, Top Level.SchDoc]
2019-03-26 Add generic components and V1 high-current supply
    I rolled the Molex connector into a 'Connectors' SchLib/PcbLib and
    created a 'Generic Passive Components' library for resistors,
    capacitors, inductors, etc. for initial schematic modeling.
    And because I'm running so far behind, I implemented my first schematic,
    the high-current power supply.
    [Power Management.SchDoc, TennisButler PCB.PcbDoc, TennisButler V1.0.SchDoc, TennisButler.PrjPcb, Top Level.SchDoc]
2019-03-28 Complete Power Management system
    This update adds the low- and high-current power supply systems with
    their current measuring ICs. Not all passives are sourced, but a few of
    the critical ones - high-current supply output capacitors and shunt
    resistors - are chosen.
    [Microcontroller.SchDoc, Motor Driver and Encoder.SchDoc, Power Management.SchDoc, TennisButler V1.0.SchDoc, TennisButler.PrjPcb]
2019-03-28 Fix top-level sheet name
    [Tennis Butler V1.0.SchDoc, TennisButler.PrjPcb]
2019-03-28 Add power connector and reverse voltage protection
    [Motor Driver and Encoder.SchDoc, Power Management.SchDoc, Tennis Butler V1.0.SchDoc]
2019-03-28 Renamed schematic library for clarity
    I can put all my reverse polarity protection hardware here - PMOS, NMOS,
    and even Schottky diodes.
2019-03-29 Finalize power, add initial work on motor driver
    General check-in of assorted work. The schematic has been cleaned up
    some (I discovered how to do X/Y flip on that FET yay), and I've started
    the motor driver schematic.
    [Motor Driver and Encoder.SchDoc, Power Management.SchDoc, Tennis Butler V1.0.SchDoc, TennisButler.PrjPcb]
2019-03-30 Complete driver-counter schematics
    This should finish off the driver-counter schematic sheet. I went with
    a 40MHz crystal because why not. The load capacitance of that Fox
    crystal is 12pF, which brings the capacitors to a 12pF-14pF range (see
    LS7366R datasheet) depending on whether there's any extra coupling
    capacitance between the crystal and ground.
    [Motor Driver and Encoder.SchDoc, Power Management.SchDoc, Tennis Butler V1.0.SchDoc]
2019-03-31 Update ATmega2560 from IPC Footprint Wizard
    I tried to get 0.12mm (5mil) separation between pins but they're 0.5mm
    pitch and it's just too much of a pain. Will probably have to reflow
    or drag-solder and clean it up with a wick.
    [TennisButler PCB.PcbDoc]
2019-03-31 Begin microcontroller connections
    This commit adds a 16MHz crystal, a 3x2 ICSP header, a number of MCU
    connections (and harnesses!) and some schematic sheet adjustments,
    including a 'repeat' command on the driver sheet!
    There's still a lot more to be done, however.
    [Microcontroller.SchDoc, Motor Driver and Encoder.SchDoc, Power Management.SchDoc, Tennis Butler V1.0.SchDoc, TennisButler PCB.PcbDoc, TennisButler.PrjPcb]
2019-03-31 Add additional connectors
    [Microcontroller.SchDoc, Motor Driver and Encoder.SchDoc, Power Management.SchDoc, Tennis Butler V1.0.SchDoc, TennisButler PCB.PcbDoc, TennisButler.PrjPcb]
2019-04-03 Add additional connectors and MCU hookups
    [Microcontroller.SchDoc, Motor Driver and Encoder.SchDoc, Tennis Butler V1.0.SchDoc]
2019-04-04 Update schematics and template for longer title
    I'd like to nest the motor driver and the encoder counter within their
    own sub-sheets for clarity, and actually call it 'encoder counter'
    instead of 'encoder' for clarity, which necessitated some minor template
    changes.
    [Microcontroller.SchDoc, Motor Driver and Encoder.SchDoc, Power Management.SchDoc, Tennis Butler V1.0.SchDoc, TennisButler.PrjPcb]
2019-04-09 Add Molex connectors with STEPs, SOT-23
2019-04-09 Add significant update to schematic
    This update breaks the motors into three top-level modules (since
    REPEAT() and harnesses don't play so well together). Includes an
    early pass at the PCB to estimate layout.
    [Microcontroller.SchDoc, Motor Driver and Encoder.SchDoc, Power Management.SchDoc, Tennis Butler V1.0.SchDoc, TennisButler PCB.PcbDoc, TennisButler.PrjPcb]
2019-04-09 Add an assortment of Molex SL Modular connectors
    As it turns out, I didn't actually need to model the 70543 (no peg)
    connectors because those will be added to the Pi HAT and aren't actually
    on my PCB, oops. Well, maybe they'll be handy later on. Most of the
    work was in implementing the 8-pin 70545-0077 anyway, the rest was just
    copy-pasting and ripping pins and pegs out.
2019-04-09 Extract power supply schematics; further updates
    The schematic progresses! Also, I separated out the high- and
    low-current power supplies into their own schematic sheets, it's a lot
    clear now. Now if only I could figure out how to do that with the
    ATmega2560 MCU without, say, splitting it into multiple parts.
    Actually...
    [High-Current Power Supply.SchDoc, LED Driver.SchDoc, Low-Current Power Supply.SchDoc, Microcontroller.SchDoc, Motor Driver and Encoder.SchDoc, Power Management.SchDoc, SBC Interface.SchDoc, Tennis Butler V1.0.SchDoc]
2019-04-18 Break out motor drivers and high-current supply
    Time is short! I've moved the VNH5019-E drivers and the
    high-current supply off-board to save time, better match
    the breadboard setup, and generally reduce risk.
    [High-Current Power Supply.SchDoc, LED Driver.SchDoc, Low-Current Power Supply.SchDoc, Microcontroller.SchDoc, Motor Driver and Encoder.SchDoc, Power Management.SchDoc, Tennis Butler V1.0.SchDoc, TennisButler PCB.PcbDoc]
2019-04-19 Rearrange encoder cable and label wire colors
    [Motor Driver and Encoder.SchDoc]
2019-04-23 Add Molex 2-pin SL header with pegs
2019-04-23 Update schematic templates, add misc. connections
    This update adds the Miscellaneous Connectors schematic sheet where
    hopefully I can break out the SPI and I2C buses for expansions as well
    as some GPIO pins from the Mega.
    The LED Driver and SBC Interface sheets are currently incomplete but
    should be pretty quick - the LED Driver is just a header for the
    Adafruit PCA9685 breakout PCB and the SBC Interface is just connectors
    and a TXB0108.
    Finally, I actually went through and ensured all of the schematic
    sheets, old and new, are using my template and have their page
    properties set correctly.
    [High-Current Power Supply.SchDoc, LED Driver.SchDoc, Low-Current Power Supply.SchDoc, Microcontroller.SchDoc, Miscellaneous Connectors.SchDoc, Motor Driver and Encoder.SchDoc, Power Management.SchDoc, SBC Interface.SchDoc]
2019-04-23 Add SN74LV4T125 and tweak other footprints
    I removed the "tented" option from all of the pins covered by the
    large (0.4mm+) solder mask expansion for cheap Seeed service.
2019-04-23 General schematic additions and organization
    Almost there! The level shifter, LED driver breakout and some
    miscellaneous connectors (SPI and I2C breakout, ICSP, and GPIO header)
    are all that remain.
    [LED Driver.SchDoc, Microcontroller.SchDoc, Miscellaneous Connectors.SchDoc, Motor Driver and Encoder.SchDoc, SBC Interface.SchDoc, SPI Control.SchDoc, Tennis Butler V1.0.SchDoc, TennisButler PCB.PcbDoc]
2019-04-24 Shrink stencil mask holes on TSSOP by -0.025mm
    TI's SN74LV4T125 datasheet (as well as other sheets I've found)
    recommend shrinking the solder stencil holes slightly (by about
    1mil), presumably to help with alignment issues and to go light on
    solder paste. I've updated the TSSOP footprint for both the
    SN74LV4T125 and the LS7366R accordingly.
2019-04-24 Complete the schematic
    I still have to finalize some part choices and add a few more footprints
    but the terrible job of final layout can begin soon.
    [High-Current Power Supply.SchDoc, LED Driver.SchDoc, Low-Current Power Supply.SchDoc, Microcontroller.SchDoc, Miscellaneous Connectors.SchDoc, Motor Driver and Encoder.SchDoc, Power Management.SchDoc, SBC Interface.SchDoc]
2019-04-24 Assign real devices to (almost) all components
    With the exception, I think, of the sense resistors, all components are
    selected. The INA199s and the RT9069 don't have models yet, and the IPC
    Footprint Wizard doesn't get the idea of a 5-pin SOT-89, so it's
    probably a good time to switch to a LM317 anyway!
    Trying to import what I've got to the PCB seems like it works very well,
    I just need to implement those remaining models... but for some reason
    the TXB0108 (which is properly implemented as far as I can tell) also
    throws an error. Maybe that'll resolve itself once I tie off absolutely
    every last loose end, we'll see.
    Also I switched the so-so green power LED out for a very bright blue Ga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
    [High-Current Power Supply.SchDoc, Low-Current Power Supply.SchDoc, Microcontroller.SchDoc, Motor Driver and Encoder.SchDoc, Power Management.SchDoc, SBC Interface.SchDoc, SPI Control.SchDoc, TennisButler PCB.PcbDoc]
2019-04-25 Add substantial progress on the PCB layout
    [High-Current Power Supply.SchDoc, LED Driver.SchDoc, Low-Current Power Supply.SchDoc, Microcontroller.SchDoc, Miscellaneous Connectors.SchDoc, Motor Driver and Encoder.SchDoc, Power Management.SchDoc, SBC Interface.SchDoc]
2019-04-28 Add significant PCB layout progress
    This commit brings the PCB much closer to completion. Updates include:
    * Completed low-power room
    * Better crystal layouts
    * Updated SBC to use a single 10-pin connector
    * Mostly-final placement of the SBC interface and MCU
    * Extraction of MCU support components to their own schematic sheet
    * Rearrangement of multiple MCU pin choices to optimize board use
    * Lots and lots of careful PCB work
    [High-Current Power Supply.SchDoc, Low-Current Power Supply.SchDoc, Microcontroller Support.SchDoc, Microcontroller.SchDoc, Miscellaneous Connectors.SchDoc, Motor Driver and Encoder.SchDoc, Power Management.SchDoc, SBC Interface.SchDoc]
2019-04-28 Add a completed first-pass PCB
    Well, it passes my DRC rules, at least. Time to submit to some
    Gerber viewers and see what's what.
    [Microcontroller Support.SchDoc, Microcontroller.SchDoc, Miscellaneous Connectors.SchDoc, Motor Driver and Encoder.SchDoc, SBC Interface.SchDoc, SPI Control.SchDoc, TennisButler PCB.PcbDoc, TennisButler.PrjPcb]
2019-04-30 Backup of all content before Elecrow version
    I'm going to try and update the board to Elecrow's standards and send
    off a second order. This is archival of the board in its current
    Seeed format, which we can revert to if necessary.
    [High-Current Power Supply.SchDoc, TennisButler PCB.PcbDoc, TennisButler.PrjPcb]
2019-05-01 Fix board outline and create documentation job
    Looks like the board layer has been badly nerfed for a while, and
    was even sent to manufacture like that, ugh. Hopefully it doesn't delay
    anything.
    I also build a documentation job and created some PDFs to include in the
    report and on the displays.
    [Microcontroller Support.SchDoc, Motor Driver and Encoder.SchDoc, SBC Interface.SchDoc, TennisButler PCB.PcbDoc, TennisButler.PrjPcb]
2019-05-01 Update docs job to output PCB soldermask layers
    [TennisButler.PrjPcb]
2019-05-01 Correct all schematic templates and reorder
    Oops, a couple of schematic sheets didn't have a template. Fixed!
    [High-Current Power Supply.SchDoc, Low-Current Power Supply.SchDoc, Microcontroller Support.SchDoc, Microcontroller.SchDoc, Miscellaneous Connectors.SchDoc, Motor Driver and Encoder.SchDoc, Power Management.SchDoc, SBC Interface.SchDoc]
2019-05-02 Add miscellaneous PCB updates
    [TennisButler PCB.PcbDoc]
2019-05-12 Update PCB PDF documentation, add reflow profile
    [Slow (0.5C) Reflow Profile.xlsx, TennisButler PCB.PcbDoc, TennisButler.PrjPcb]
2019-05-26 Tweak layer stackup, re-export rules with AD 19.1
    I've been investigating impedance profiles and fine-tuning the layer
    stackup manager, trying to get a feel for tolerances and how to make
    100Ω traces.
    Also, it looks like rule import/export is fixed in Altium 19.1, so I
    re-exported the rule set on master and was able to re-import it without
    too much trouble. Hooray! I can now set up separate rulesets for both
    Seeed (0.1mm and 0.4mm) and Elecrow and anyone else.
    [TennisButler PCB.PcbDoc, TennisButler.PrjPcb]
